titetil/smart-tank-pcb/AIO.PNG

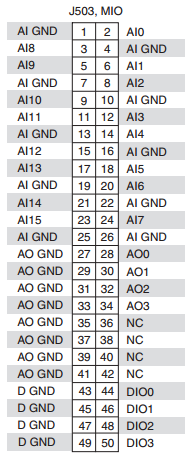
AIO.PNG
