titetil/smart-tank-pcb/RMC.PNG

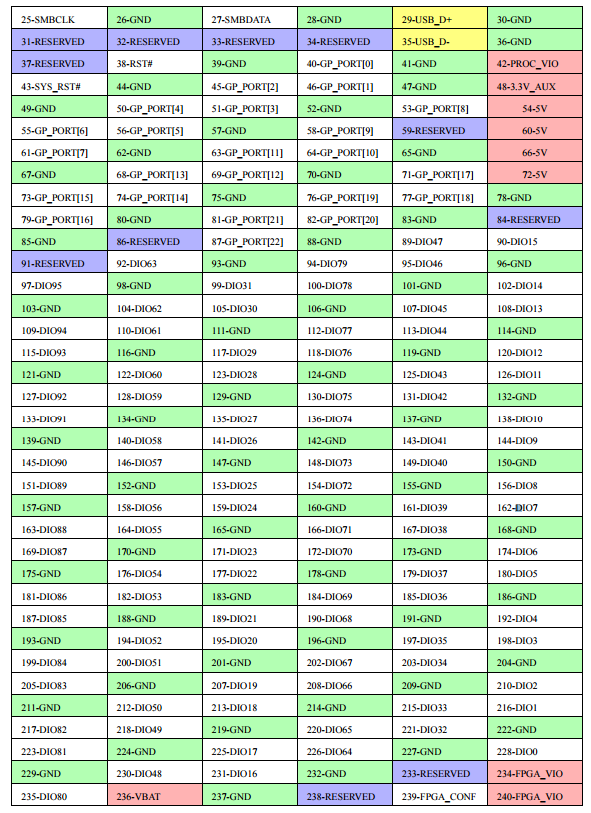
RMC.PNG
