titetil/smart-tank-pcb/Motherboard/Smart Tank PCB (Bill of Materials), v1.2.xlsx

# | Qty | Part Number | Description | Manufacturer | Distributor | Link | Price | Total | Refdef | PCB | TE Supplied
1 | 7 | 1755752 | TERMINAL BLOCK HEADER, MALE, 12A, 4 POS, 5.08mm | PHOENIX CONTACT | DIGIKEY | Link (http://www.digikey.com/product-detail/en/phoenix-contact/1755752/277-1152-ND/260520) | $1.66 | $11.62 | PWR_CONN1, PUMP_V_CONN_1-6 | X
2 | 7 | 1792265 | TERMINAL BLOCK PLUG, FEMALE, 12A, 4 POS, 5.08mm, SCREW | PHOENIX CONTACT | DIGIKEY | Link (http://www.digikey.com/product-detail/en/phoenix-contact/1792265/277-1042-ND/260410) | $5.01 | $35.07 | -
3 | 1 | 1755778 | TERMINAL BLOCK HEADER, MALE, 12A, 6 POS, 5.08mm | PHOENIX CONTACT | DIGIKEY | Link (http://www.digikey.com/product-search/en?keywords=1755778) | $1.63 | $1.63 | AO_CONN1 | X
4 | 1 | 1792281 | TERMINAL BLOCK PLUG, FEMALE, 12A, 6 POS, 5.08mm, SCREW | PHOENIX CONTACT | DIGIKEY | Link (http://www.digikey.com/product-detail/en/phoenix-contact/1792281/277-1044-ND/260412) | $5.81 | $5.81 | -
5 | 5 | 1755817 | TERMINAL BLOCK HEADER, MALE, 12A, 10 POS, 5.08mm | PHOENIX CONTACT | DIGIKEY | Link (http://www.digikey.com/product-detail/en/phoenix-contact/1755817/277-1158-ND/260526) | $3.66 | $18.30 | GPIO_CONN1, PRESSURE_CONN1, FLOW_CONN1, PH_VOLT_CONN1, SP1-6_CONN1 | X
6 | 5 | 1792320 | TERMINAL BLOCK PLUG, FEMALE, 12A, 10 POS, 5.08mm, SCREW | PHOENIX CONTACT | DIGIKEY | Link (http://www.digikey.com/product-detail/en/phoenix-contact/1792320/277-1048-ND/260416) | $11.27 | $56.35 | -
7 | 12 | 1906129 | TERMINAL BLOCK, 30A, 4 POS, 9.53mm, SCREW | PHOENIX CONTACT | DIGIKEY | Link (https://www.digikey.com/en/products/detail/phoenix-contact/1906129/3597016) | $4.30 | $51.60 | PUMP_PWR_CONN_1-6, PUMP_CONN_1-6 | X
8 | 1 | 1729128 | TERMINAL BLOCK, 10A, 2 POS, 5.08mm, SCREW | PHOENIX CONTACT | DIGIKEY | Link (http://www.digikey.com/product-detail/en/phoenix-contact/1729128/277-1247-ND/260615) | $1.33 | $1.33 | RIO_PWR_CONN_1 | X
9
10 | 6 | CBD13W6F35S600X/AA | D-SUB CONNECTOR, PCB, FEMALE, 6 POWER, 7 SIGNAL | POSITRONIC | POSITRONIC | Link (https://www.posishop.com/store/default.aspx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) | $25.93 | $155.58 | CTRL_CONN_1-6 | X | X
11 | 6 | D00000T0/AA | JACKSCREWS, FEMALE, PAIR | POSITRONIC | POSITRONIC | Link (https://www.posishop.com/store/default.aspx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) | $1.80 | $10.80 | - |  | X
12 | 6 | CBD13W6M2000Z/AA | D-SUB CONNECTOR, MATING, MALE, 6 POWER, 7 SIGNAL | POSITRONIC | POSITRONIC | Link (https://www.posishop.com/store/default.aspx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) | $5.02 | $30.12 | - |  | X
13 | 36 | MS4012D/AA | REMOVABLE CONTACT, SOLDER CUP, SIZE 8, MALE | POSITRONIC | POSITRONIC | Link (https://www.posishop.com/store/default.aspx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) | $0.78 | $28.08 | - |  | X
14 | 6 | D37000Z00/AA | D-SUB HOOD, MALE JACKSCREWS | POSITRONIC | POSITRONIC | Link (https://www.posishop.com/store/default.aspx?appname=Store&tabname=Product+Selection&PartNumber=D37000Z00/AA) | $6.16 | $36.96 | - |  | X
15
16 | 1 | SEAM-40-03.0-S-06-2-A-K-TR | .050" SEARAY™, 240 Pins | SAMTEC | SAMTEC | Link (https://www.digikey.com/en/products/detail/samtec-inc/SEAM-40-03-0-S-06-2-A-K-TR/6561658) | $22.38 | $22.38 | RMC_CONN1 | X
17
18 | 1 | SBH11-PBPC-D25-ST-BK | CONN HEADER, 0.1", 50 POS, GOLD | SULLINS | DIGIKEY | Link (http://www.digikey.com/product-detail/en/sullins-connector-solutions/SBH11-PBPC-D25-ST-BK/S9176-ND/1990069) | $0.92 | $0.92 | EXPANSION_CONN1 | X
19 | 1 | SBH21-NBPN-D25-ST-BK | CONN HEADER, 2mm, 50 POS, GOLD | SULLINS | DIGIKEY | Link (http://www.digikey.com/product-detail/en/sullins-connector-solutions/SBH21-NBPN-D25-ST-BK/S9026-ND/1989759) | $1.27 | $1.27 | RIO_AIO_CONN1 | X
20 | 4 | SBH11-PBPC-D05-ST-BK | CONN HEADER, 0.1", 10 POS, GOLD | SULLINS | DIGIKEY | Link (https://www.digikey.com/en/products/detail/sullins-connector-solutions/SBH11-PBPC-D05-ST-BK/1990062) | $0.29 | $1.16 | HMI_CONN1, RS232_CONN1, RS485_CONN1, CAN_CONN1 | X
21 | 1 | HCSD-05-D-02.00-01-N-G | 10 POS, 0.1", IDC CONNECTOR ASSEMBLY, 2" | SAMTEC | SAMTEC | Link (https://www.samtec.com/products/hcsd-05-d-02.00-01-n-g) | $6.59 | $6.59 | - |  | X
22 | 1 | HCSD-05-D-04.00-01-N-G-R | 10 POS, 0.1", IDC CONNECTOR ASSEMBLY, REVERSE, 4" | SAMTEC | SAMTEC | Link (https://www.samtec.com/products/hcsd-05-d-04.00-01-n-g-r) | $6.66 | $6.66 | - |  | X
23 | 1 | TCSD-25-D-01.25-01-N | 50 POS, 2mm, IDC CONNECTOR ASSEMBLY, 1.25" | SAMTEC | SAMTEC | Link (https://www.samtec.com/products/tcsd) | $14.28 | $14.28 | - |  | X
24
25 | 11 | 63969-1 | CONN QC RCPT 0.205/0.250 SOLDER | TE CONNECTIVITY | DIGIKEY | Link (https://www.digikey.com/en/products/detail/te-connectivity-amp-connectors/63969-1/1131770) | $0.26 | $2.86 | CAL2-12 | X
26 | 1 | 961103-6404-AR | CONN HEADER, 3 POS, 0.1", STR, GOLD | 3M | DIGIKEY | Link (https://www.digikey.com/product-detail/en/3m/961103-6404-AR/3M9457-03-ND/7104634?WT.srch=1) | $0.57 | $0.57 | PWR_SEL1 | X
27 | 1 | SNT-100-BK-G | JUMPER, 2 POS, 0.1", GOLD | SAMTEC | DIGIKEY | Link (https://www.digikey.com/en/products/detail/samtec-inc/SNT-100-BK-G/1756763) | $0.31 | $0.31 | -
28 | 1 | SDA12H1SBD | SWITCH SLIDE DIP SPST 0.025A 24V, 12 POS | C&K | DIGIKEY | Link (https://www.digikey.com/en/products/detail/c-k/SDA12H1SBD/949963) | $3.70 | $3.70 | VOLT_SENSE1 | X
29 | 1 | B3FS-1002P | SWITCH TACTILE SPST-NO 0.05A 24V | OMRON | DIGIKEY | Link (https://www.digikey.com/en/products/detail/omron-electronics-inc-emc-div/B3FS-1002P/277813) | $0.45 | $0.45 | RST_SW1 | X
30
31 | 1 | G6L-1F-DC24 | RELAY, SPST, 24V COIL, 1A CONTACT | OMRON | DIGIKEY | Link (http://www.digikey.com/product-detail/en/omron-electronics-inc-emc-div/G6L-1F-DC24/Z2040-ND/503110) | $3.43 | $3.43 | E-STOP_RLY1 | X
32 | 6 | VCF4-1000 | RELAY SOCKET, 30A | TE | DIGIKEY | Link (http://www.digikey.com/product-detail/en/te-connectivity-potter-brumfield-relays/VCF4-1000/PB232-ND/207273) | $3.01 | $18.06 | PWR_RLY_1-6 | X
33 | 6 | A21CSQ24VDC1.6 | RELAY AUTOMOTIVE SPDT 40A 24V | CIT | DIGIKEY | Link (https://www.digikey.com/en/products/detail/cit-relay-and-switch/A21CSQ24VDC1-6/12418796) | $2.50 | $15.00 | -
34
35 | 6 | INA240A2EDRQ1 | IC CURRENT SENSE 1 CIRCUIT 8SOIC | TI | DIGIKEY | Link (https://www.digikey.com/en/products/detail/texas-instruments/INA240A2EDRQ1/9861455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) | $4.03 | $24.18 | PUMP_AMPS_1-6 | X
36 | 6 | INA240A3EDRQ1 | IC CURRENT SENSE 1 CIRCUIT 8SOIC | TI | DIGIKEY | Link (https://www.digikey.com/en/products/detail/texas-instruments/INA240A3EDRQ1/9861456) | $4.03 | $24.18 | CTRL_AMPS_1-6 | X
37 | 12 | WSL40261L000FEA | RES 0.001 OHM 1% 3W 4026 | VISHAY DALE | DIGIKEY | Link (https://www.digikey.com/en/products/detail/texas-instruments/INA240A3EDRQ1/9861456) | $2.62 | $31.44 | PUMP_SHUNT_1-6, CTRL_SHUNT_1-6 | X
38 | 4 | ADS8332IBPWR | IC ADC 16BIT SAR 24TSSOP | TI | DIGIKEY | Link (https://www.digikey.com/en/products/detail/texas-instruments/ADS8332IBPWR/2695887) | $14.40 | $57.60 | ADC_AI16-23, ADC_AI24-31, ADC_AI32-39, ADC_AI40-47 | X
39 | 2 | LM358DT | IC OPAMP GP 1.1MHZ 8SO | ST MICROELECTRONICS | DIGIKEY | Link (http://www.digikey.com/product-detail/en/stmicroelectronics/LM358DT/497-1591-1-ND/592083) | $0.18 | $0.36 | U1, U2 | X
40
41 | 14 | 01220083Z | FUSE CLIP CARTRIDGE 250V 30A PCB | LITTELFUSE | DIGIKEY | Link (http://www.digikey.com/product-detail/en/littelfuse-inc/01220083Z/F3782-ND/2498890) | $0.86 | $12.04 | 24VDC_FUSE1, PUMP_FUSE_1-6 | X
42 | 1 | 0312003.MXP | FUSE GLASS 3A 250VAC 3AB 3AG | LITTELFUSE | DIGIKEY | Link (http://www.digikey.com/product-search/en?keywords=0312003.MXP) | $0.52 | $0.52 | -
43 | 6 | 0326025.MXP | FUSE CERM 25A 250VAC 125VDC 3AB | LITTELFUSE | DIGIKEY | Link (http://www.digikey.com/product-detail/en/littelfuse-inc/0326025.MXP/F1778-ND/778638) | $2.23 | $13.38 | -
44
45 | 6 | ZVN3320FTA | MOSFET N-CH 200V 0.60A SOT-23-3 | DIODES INCORPORATED | DIGIKEY | Link (https://www.digikey.com/en/products/detail/diodes-incorporated/ZVN3320FTA/152481) | $0.42 | $2.52 | Q3, Q8, Q12, Q16, Q20, Q24 | X
46 | 7 | DMN61D8LQ-13 | MOSFET N-CH 60V 470MA SOT23 | DIODES INCORPORATED | DIGIKEY | Link (https://www.digikey.com/en/products/detail/diodes-incorporated/DMN61D8LQ-13/5488598) | $0.74 | $5.18 | Q1, Q2, Q10, Q14, Q18, Q22, Q26 | X
47
48 | 6 | S1J | DIODE STANDARD 600V 1A DO214AC | DIOTEC | DIGIKEY | Link (https://www.digikey.com/en/products/detail/diotec-semiconductor/S1J/13163889) | $0.14 | $0.84 | D1, D3, D4, D5, D7, D9 | X
49 | 6 | 1N4148W-TP | DIODE GEN PURP 100V 150MA SOD123 | MICRO COMMERCIAL | DIGIKEY | Link (http://www.digikey.com/product-detail/en/micro-commercial-co/1N4148W-TP/1N4148WTPMSCT-ND/717311) | $0.12 | $0.75 | D6, D8, D10, D12, D14-15 | X
50 | 1 | RC1206JR-07120RL | RES SMD 120 OHM 5% 1/4W 1206 | YAGEO | DIGIKEY | Link (http://www.digikey.com/product-detail/en/yageo/RC1206JR-07120RL/311-120ERCT-ND/732162) | $0.02 | $0.02 | R19 | X
51 | 6 | RC1206JR-13150RL | RES 150 OHM 5% 1/4W 1206 | YAGEO | DIGIKEY | Link (https://www.digikey.com/en/products/detail/yageo/RC1206JR-13150RL/14286768) | $0.10 | $0.60 | R5, R52, R61, R70, R79, R88 | X
52 | 12 | RG3216P-2490-B-T1 | RES SMD 249 OHM 0.1% 1/4W 1206 | SUSUMU | DIGIKEY | Link (http://www.digikey.com/product-detail/en/susumu/RG3216P-2490-B-T1/RG32P249BCT-ND/2078665) | $0.24 | $2.88 | R20-31 | X
53 | 6 | RC1206JR-132KL | RES 2K OHM 5% 1/4W 1206 | YAGEO | DIGIKEY | Link (https://www.digikey.com/en/products/detail/yageo/RC1206JR-132KL/17016463) | $0.10 | $0.60 | R1, R8-12 | X
54 | 6 | RC1206JR-0710KL | RES 10K OHM 5% 1/4W 1206 | YAGEO | DIGIKEY | Link (https://www.digikey.com/en/products/detail/yageo/RC1206JR-1310KL/14286743) | $0.10 | $0.60 | R6, R49, R58, R67, R76, R85 | X
55 | 12 | RNCS1206BKE10K0 | RES SMD 10K OHM 0.1% 1/8W 1206 | STACKPOLE ELECTRONICS | DIGIKEY | Link (https://www.digikey.com/product-detail/en/stackpole-electronics-inc/RNCS1206BKE10K0/RNCS1206BKE10K0CT-ND/1800331) | $0.17 | $2.04 | R2, R14, R16, R33, R35, R37, R47, R56, R65, R74, R83, R92 | X
56 | 2 | RNCF1206BKC15K0 | RES SMD 15K OHM 0.1% 1/4W 1206 | STACKPOLE ELECTRONICS | DIGIKEY | Link (https://www.digikey.com/product-detail/en/stackpole-electronics-inc/RNCF1206BKC15K0/RNCF1206BKC15K0CT-ND/2027173) | $0.15 | $0.30 | R17, R18 | X
57 | 12 | RNCS1206BKE100K | RES SMD 100K OHM 0.1% 1/8W 1206 | STACKPOLE ELECTRONICS | DIGIKEY | Link (https://www.digikey.com/product-detail/en/stackpole-electronics-inc/RNCS1206BKE100K/RNCS1206BKE100KCT-ND/1800328) | $0.17 | $2.04 | R3, R4, R15, R32, R34, R36, R48, R57, R66, R75, R84, R93 | X
58 | 6 | RC1206JR-071ML | RES SMD 1M OHM 5% 1/4W 1206 | YAGEO | DIGIKEY | Link (http://www.digikey.com/product-detail/en/yageo/RC1206JR-071ML/311-1.0MERCT-ND/732134) | $0.10 | $0.60 | R7, R55, R64, R73, R82, R91 | X
59 | 12 | CC1206KRX7R9BB472 | 4700pF 50V CERAMIC CAPACITOR X7R 1206 | YAGEO | DIGIKEY | Link (http://www.digikey.com/product-detail/en/yageo/CC1206KRX7R9BB472/311-1173-1-ND/303083) | $0.19 | $2.28 | C20, C21, C29, C30, C33, C34, C37, C38, C41, C42, C45, C46 | X
60 | 6 | CC1206KRX7R9BB103 | CAP CER 10000PF 50V X7R 1206 | YAGEO | DIGIKEY | Link (https://www.digikey.com/en/products/detail/yageo/CC1206KRX7R9BB103/302908) | $0.19 | $1.14 | C14, C17, C23, C24, C25, C26 | X
61 | 12 | CC1206KRX7R9BB104 | 0.1µF 50V CERAMIC CAPACITOR X7R 1206 | YAGEO | DIGIKEY | Link (http://www.digikey.com/product-detail/en/yageo/CC1206KRX7R9BB104/311-1179-1-ND/303089) | $0.15 | $1.80 | C13, C15, C27, C28, C31, C32, C35, C36, C39, C40, C43, C44 | X
62 | 8 | CC1206ZRY5V7BB475 | 4.7µF 16V CERAMIC CAPACITOR Y5V (F) 1206 | YAGEO | DIGIKEY | Link (http://www.digikey.com/product-detail/en/yageo/CC1206ZRY5V7BB475/311-2011-1-ND/5195913) | $0.21 | $1.68 | C1, C3, C4, C6, C7, C9, C10, C12 | X
63 | 4 | CC1206KKX5R5BB226 | 22µF 6.3V CERAMIC CAPACITOR X5R 1206 | YAGEO | DIGIKEY | Link (http://www.digikey.com/product-detail/en/yageo/CC1206KKX5R5BB226/311-1937-1-ND/5195839) | $0.30 | $1.20 | C2, C5, C8, C11 | X
64 | 1 | EEE-HD1C100AR | CAP ALUM 10UF 20% 16V SMD | PANASONIC | DIGIKEY | Link (https://www.digikey.com/en/products/detail/panasonic-electronic-components/EEE-HD1C100AR/1985127) | $0.42 | $0.42 | C16 | X
65
66 | 19 | SMTSO-116-12ET | SURFACE MOUNT STANDOFF, 3/8", THRU HOLE, FOR 4-40 | PENN ENGINEERING | PENN ENGINEERING | Link (http://catalog.pemnet.com/item/uts-and-spacers-standoffs-surface-mount-type-smtso/spacers-standoffs---type-smtsob---unified/smtsob-116-12et) |  |  | S1-15, S24-27 | X
67 | 10 | SMTSO-440-12ET | SURFACE MOUNT STANDOFF, 3/8", 4-40 | PENN ENGINEERING | PENN ENGINEERING | Link (http://catalog.pemnet.com/item/uts-and-spacers-standoffs-surface-mount-type-smtso/spacers-standoffs---type-smtsob---unified/smtsob-440-12et) |  |  | S16-23, S28, S29 | X | X
68
69 | 1 | 91737A069 | FILLISTER SCREW, 4-40, 3/16", PACK OF 100 | McMASTER-CARR | McMASTER-CARR | Link (http://www.mcmaster.com/#91737a069/=143emwn) | $4.22 | $4.22 | SBRIO STAND-OFF |  | X
70 | 1 | 91772A113 | PAN HEAD SCREW, 4-40, 3/4", PACK OF 100 | McMASTER-CARR | McMASTER-CARR | Link (https://www.mcmaster.com/#91772a113/=19kgcxo) | $4.95 | $4.95 | PCB STAND-OFF |  | X
71
72 | 1 | CUSTOM | PCB BACKPLATE, 1/2", DELRIN, BLACK | R&S TOOL | R&S TOOL |  | $94.75 | $94.75 | Smart Tank PCB Backplate.dwg |  | X
73 | 1 | 91255A622 | ROUNDED HEAD SCREW, 3/8"-16, 3/4", PACK OF 25 | McMASTER-CARR | McMASTER-CARR | Link (http://www.mcmaster.com/#91772a110/=143enhs) | $7.54 | $7.54 | Screws for backplate |  | X
74
75
