titetil/smart-tank-pcb/Motherboard/Smart_Tank_3D/WSL4026 (0.001).stp

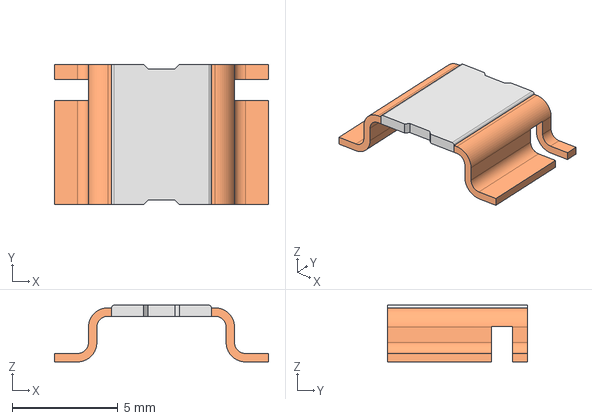
[picture p3: CAD file, 2025-11-17]
Motherboard/Smart_Tank_3D/WSL4026 (0.001).stp
10.1 x 6.60 x 2.68 mm
