titetil/smart-tank-pcb/Motherboard/Smart_Tank_3D/FEMALE_SPADE_QC_(TE_63969-1).step

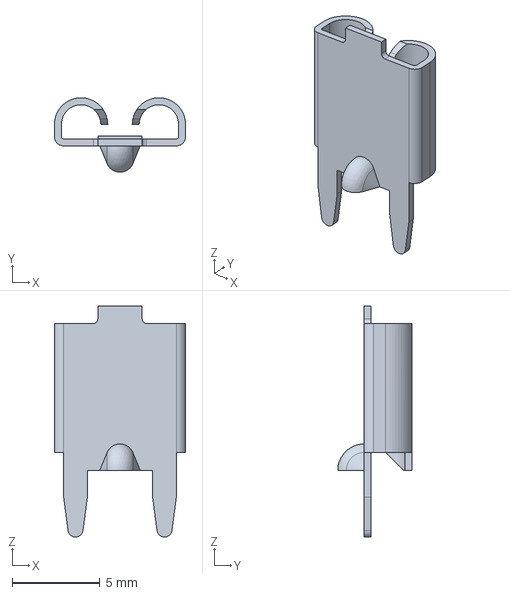
[picture p4: CAD file, 2025-11-17]
Motherboard/Smart_Tank_3D/FEMALE_SPADE_QC_(TE_63969-1).step
7.49 x 4.25 x 13.2 mm
