titetil/smart-tank-pcb/Smart Tank Controller Plate (Hella BLDC).dxf

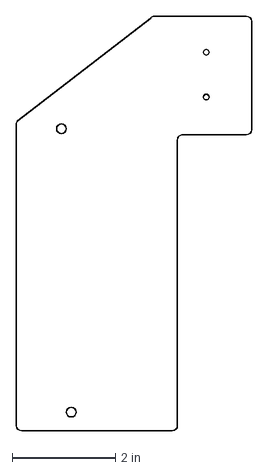
[picture p5: CAD file, 2017-07-27]
Smart Tank Controller Plate (Hella BLDC).dxf
4.56 x 8.05 in
