titetil/smart-tank-pcb/Motherboard/Smart_Tank_3D/EEEHD1C100AR.step

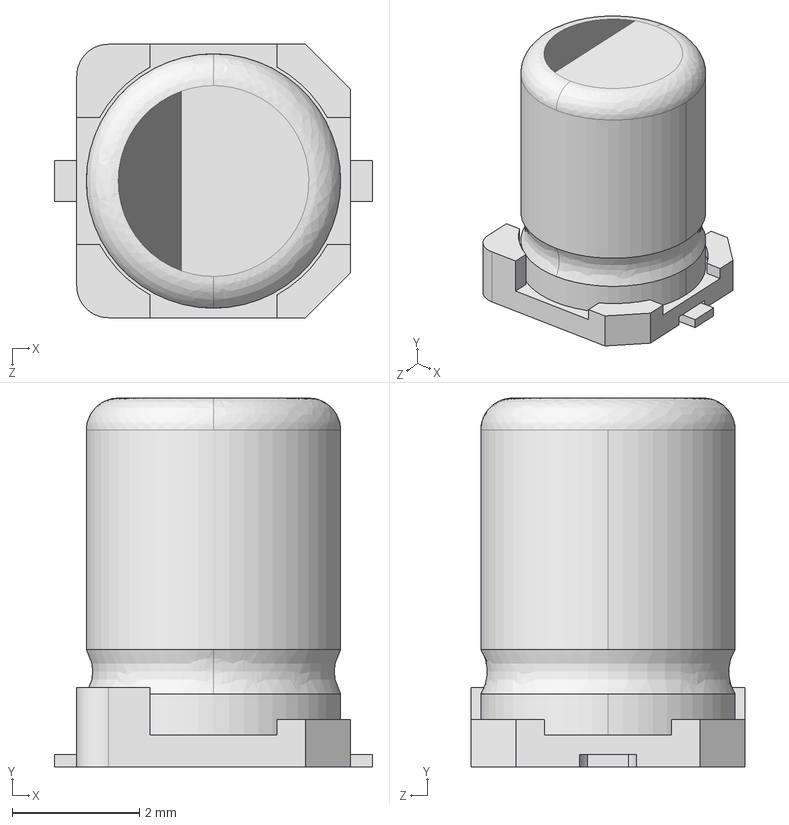
[picture p6: CAD file, 2025-11-17]
Motherboard/Smart_Tank_3D/EEEHD1C100AR.step
5.00 x 5.80 x 4.30 mm
