titetil/smart-tank-pcb/Smart Tank PCB Backplate.dxf

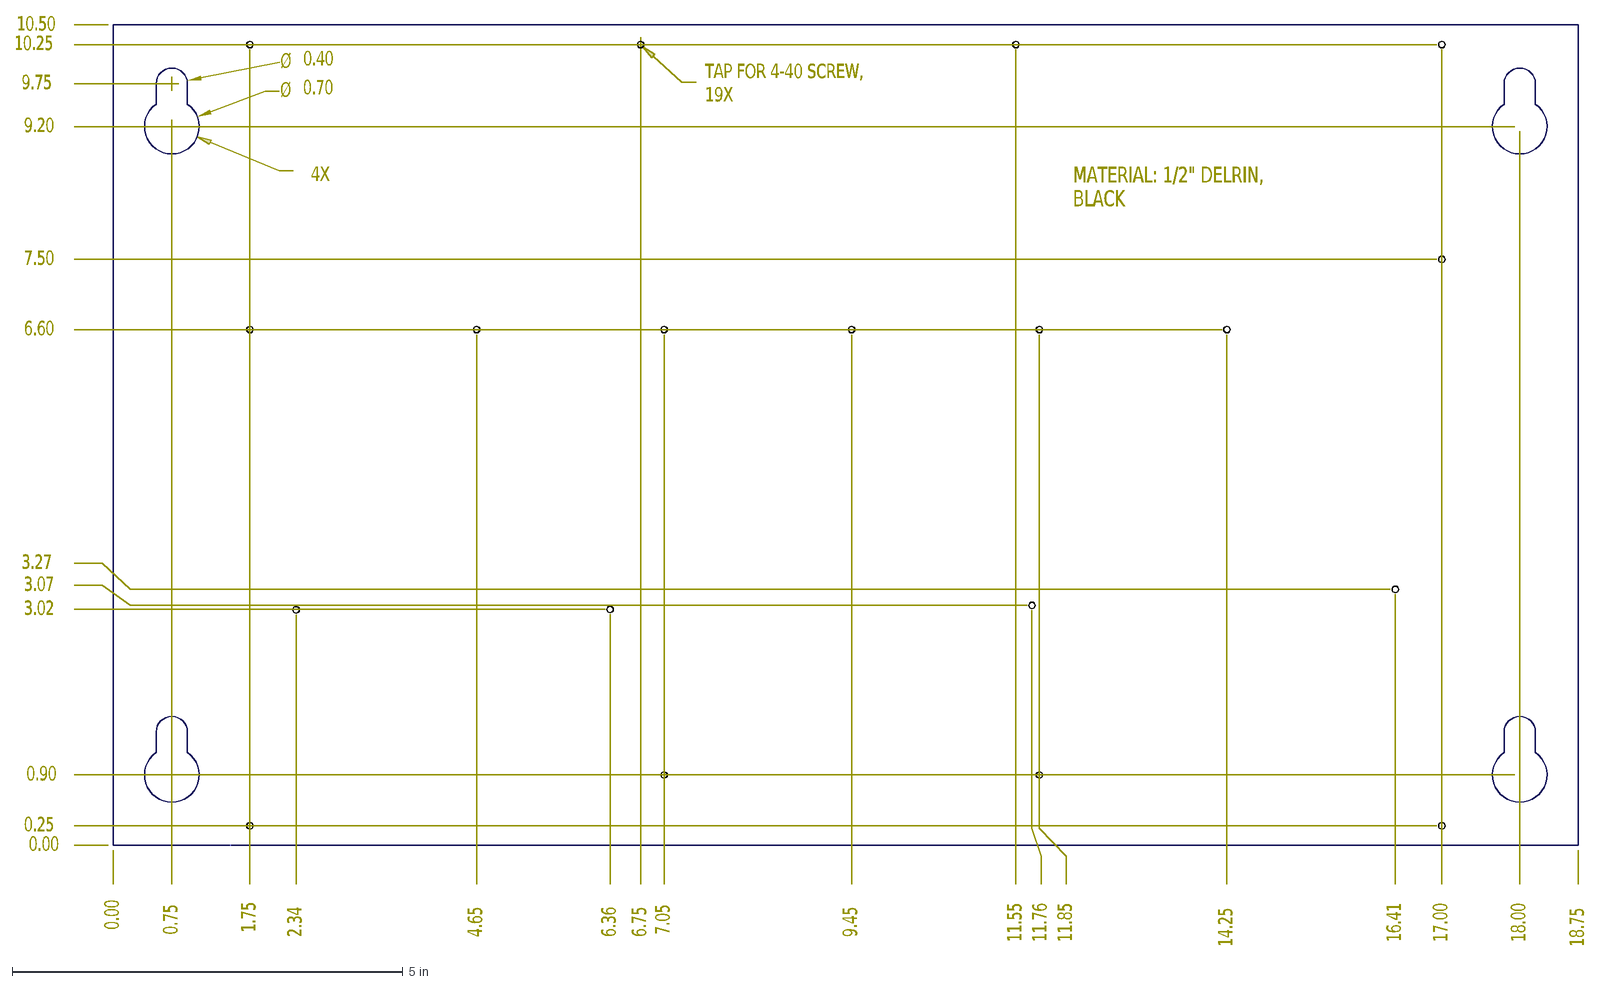
[picture p7: CAD file, 2017-03-30]
Smart Tank PCB Backplate.dxf
0.00
1.75
2.34
4.65
6.36
6.75
7.05
9.45
11.55
11.76
11.85
14.25
16.41
17.00
0.25
0.90
3.02
3.07
3.27
6.60
7.50
9.20
10.25
10.50
0.75
18.00
18.75
Ø
0.40
9.75
0.70
4X
TAP FOR 4-40 SCREW,
19X
MATERIAL: 1/2" DELRIN,
BLACK
