titetil/smart-tank-pcb/Motherboard/Smart_Tank_3D/SW_DIP_SPSTx12_(SDA12H1SBD).stp

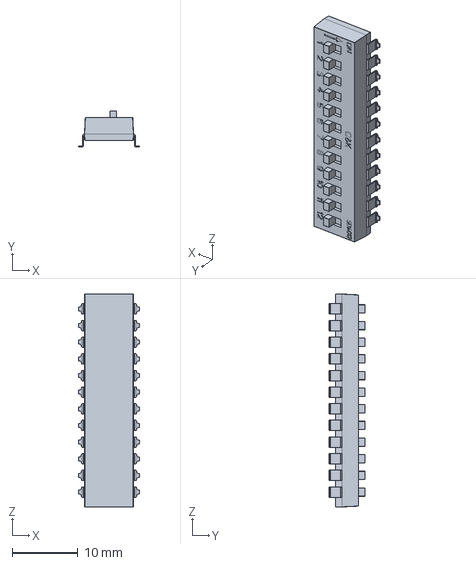
[picture p8: CAD file, 2025-11-14]
Motherboard/Smart_Tank_3D/SW_DIP_SPSTx12_(SDA12H1SBD).stp
9.30 x 5.50 x 32.5 mm
