titetil/smart-tank-pcb/(list of files, cad)

Other CAD files:
Smart Tank Controller Plate (Kuhnke).dwg
Smart Tank Controller Plate (Hella BLDC).dwg
Smart Tank PCB Backplate.dwg
