titetil/smart-tank-pcb/Smart Tank Controller Plate (Hella BLDC).pdf

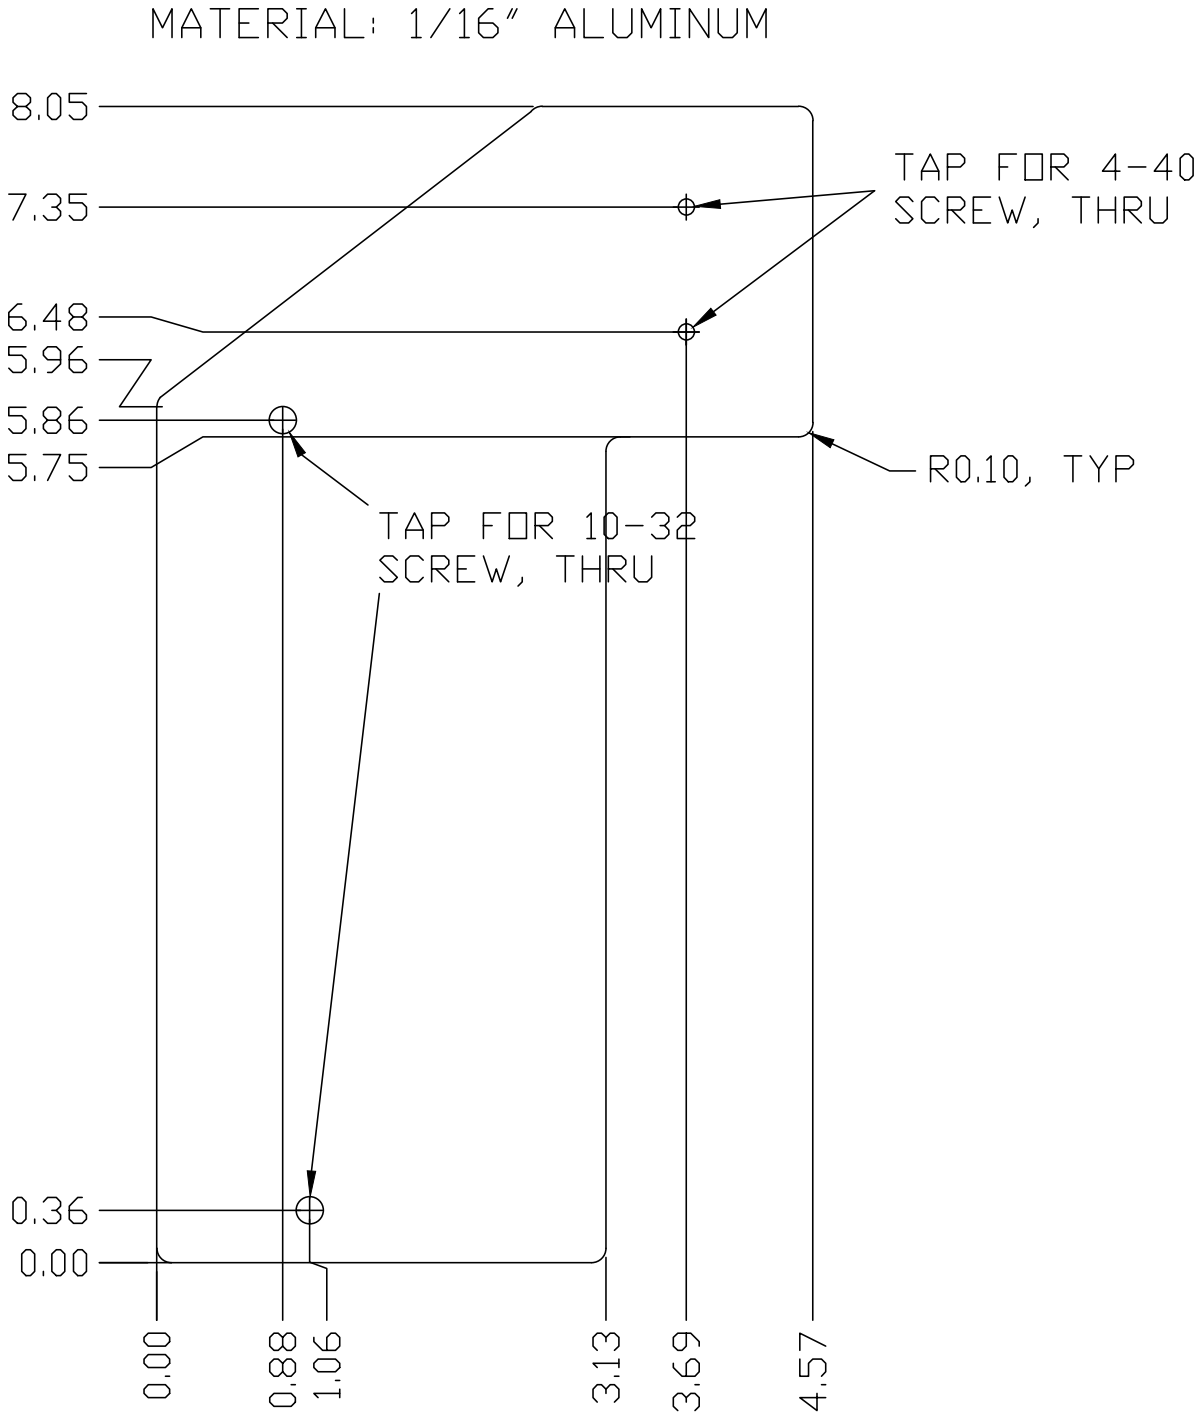
[picture p9: page 1]
