titetil/smart-tank-pcb/Smart Tank Controller Plate (Kuhnke).pdf

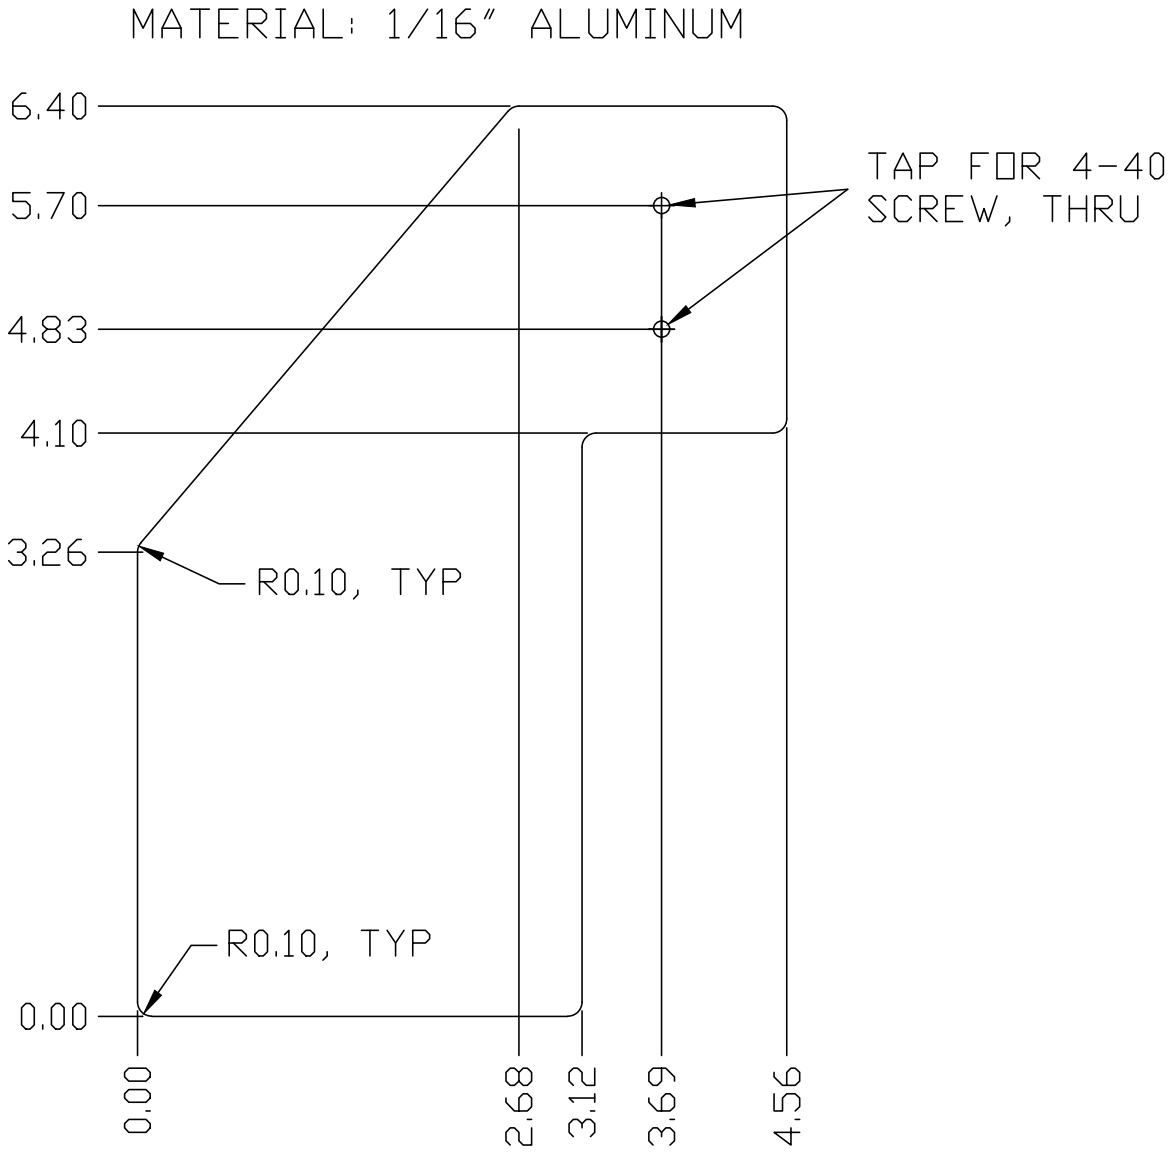
[picture p10: page 1]
