titetil/smart-tank-pcb/Smart Tank PCB Backplate.pdf

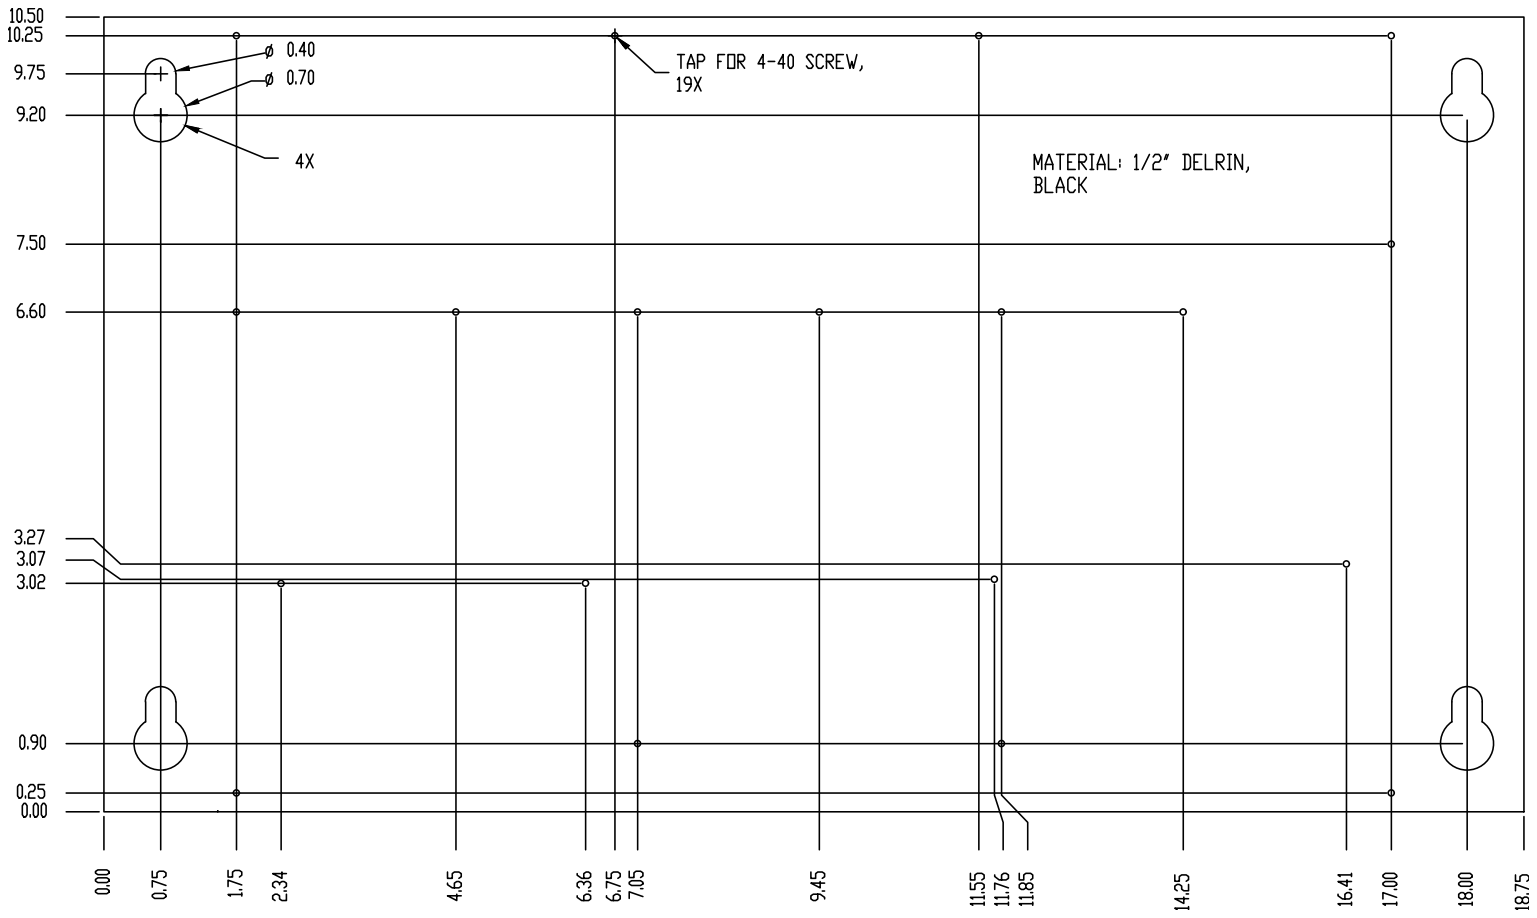
[picture p11: page 1]
