titetil/smart-tank-pcb/(list of files, drawings)

Other design files:
PWM Simulation.ms12
