titetil/smart-tank-pcb/Motherboard/Smart Tank Motherboard.kicad_pcb

## KiCad design Motherboard/Smart Tank Motherboard.kicad_pcb (2026-02-18)

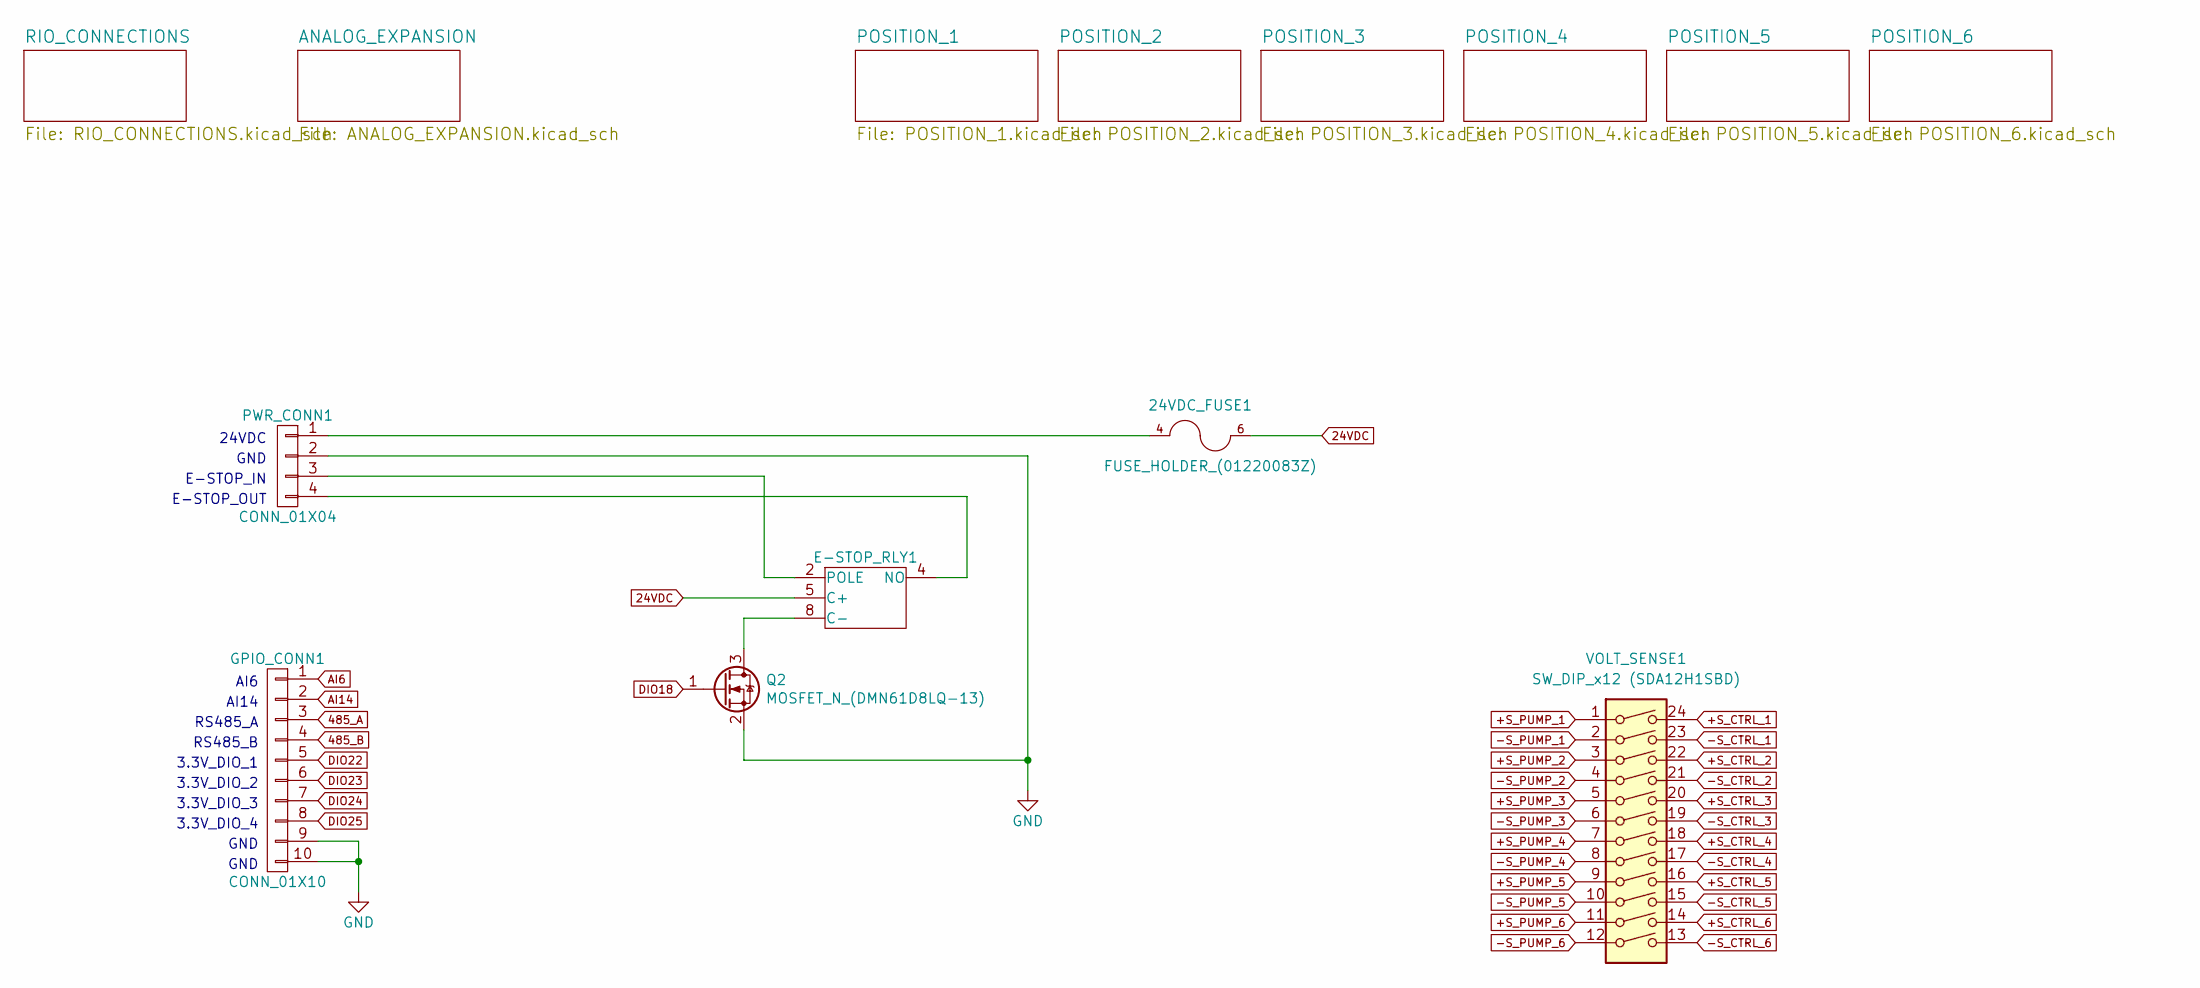
[picture p12: schematic Smart Tank Motherboard.kicad_sch]

Parts:
24VDC_FUSE1: FUSE_HOLDER_(01220083Z)
E-STOP_RLY1: OMRON_RELAY_(G6L-1F-DC24); OMRON_RELAY_1A_(G6L-1F-DC24)
GPIO_CONN1: CONN_01X10; PHX_TB_HDR_10_POS_STR_(1755817)
PWR_CONN1: CONN_01X04; PHX_TB_HDR_4_POS_STR_(1755752)
Q2: MOSFET_N_(DMN61D8LQ-13); SOT-23
VOLT_SENSE1: SW_DIP_x12 (SDA12H1SBD); SW_DIP_SPSTx12_(SDA12H1SBD)

Connections:
24VDC: 24VDC_FUSE1.6, 24VDC_FUSE1.7, E-STOP_RLY1.5 (C+); also elsewhere on the board
485_A: GPIO_CONN1.3; also elsewhere on the board
485_B: GPIO_CONN1.4; also elsewhere on the board
+S_CTRL_1: VOLT_SENSE1.24; also elsewhere on the board
+S_CTRL_2: VOLT_SENSE1.22; also elsewhere on the board
+S_CTRL_3: VOLT_SENSE1.20; also elsewhere on the board
+S_CTRL_4: VOLT_SENSE1.18; also elsewhere on the board
+S_CTRL_5: VOLT_SENSE1.16; also elsewhere on the board
+S_CTRL_6: VOLT_SENSE1.14; also elsewhere on the board
+S_PUMP_1: VOLT_SENSE1.1; also elsewhere on the board
+S_PUMP_2: VOLT_SENSE1.3; also elsewhere on the board
+S_PUMP_3: VOLT_SENSE1.5; also elsewhere on the board
+S_PUMP_4: VOLT_SENSE1.7; also elsewhere on the board
+S_PUMP_5: VOLT_SENSE1.9; also elsewhere on the board
+S_PUMP_6: VOLT_SENSE1.11; also elsewhere on the board
-S_CTRL_1: VOLT_SENSE1.23; also elsewhere on the board
-S_CTRL_2: VOLT_SENSE1.21; also elsewhere on the board
-S_CTRL_3: VOLT_SENSE1.19; also elsewhere on the board
-S_CTRL_4: VOLT_SENSE1.17; also elsewhere on the board
-S_CTRL_5: VOLT_SENSE1.15; also elsewhere on the board
-S_CTRL_6: VOLT_SENSE1.13; also elsewhere on the board
-S_PUMP_1: VOLT_SENSE1.2; also elsewhere on the board
-S_PUMP_2: VOLT_SENSE1.4; also elsewhere on the board
-S_PUMP_3: VOLT_SENSE1.6; also elsewhere on the board
-S_PUMP_4: VOLT_SENSE1.8; also elsewhere on the board
-S_PUMP_5: VOLT_SENSE1.10; also elsewhere on the board
-S_PUMP_6: VOLT_SENSE1.12; also elsewhere on the board
AI6: GPIO_CONN1.1; also elsewhere on the board
AI14: GPIO_CONN1.2; also elsewhere on the board
DIO18: Q2.1 (G); also elsewhere on the board
DIO22: GPIO_CONN1.5; also elsewhere on the board
DIO23: GPIO_CONN1.6; also elsewhere on the board
DIO24: GPIO_CONN1.7; also elsewhere on the board
DIO25: GPIO_CONN1.8; also elsewhere on the board
GND: GPIO_CONN1.9, GPIO_CONN1.10, PWR_CONN1.2, Q2.2 (S); also elsewhere on the board
unnamed: E-STOP_RLY1.8 (C-), Q2.3 (D)
unnamed: E-STOP_RLY1.4 (NO), PWR_CONN1.4
unnamed: E-STOP_RLY1.2 (POLE), PWR_CONN1.3
unnamed: 24VDC_FUSE1.4, 24VDC_FUSE1.5, PWR_CONN1.1

Notes on the sheet:
RS485_B
3.3V_DIO_3
RS485_A
E-STOP_IN
24VDC
GND
3.3V_DIO_4
E-STOP_OUT
3.3V_DIO_2
AI6
AI14
3.3V_DIO_1

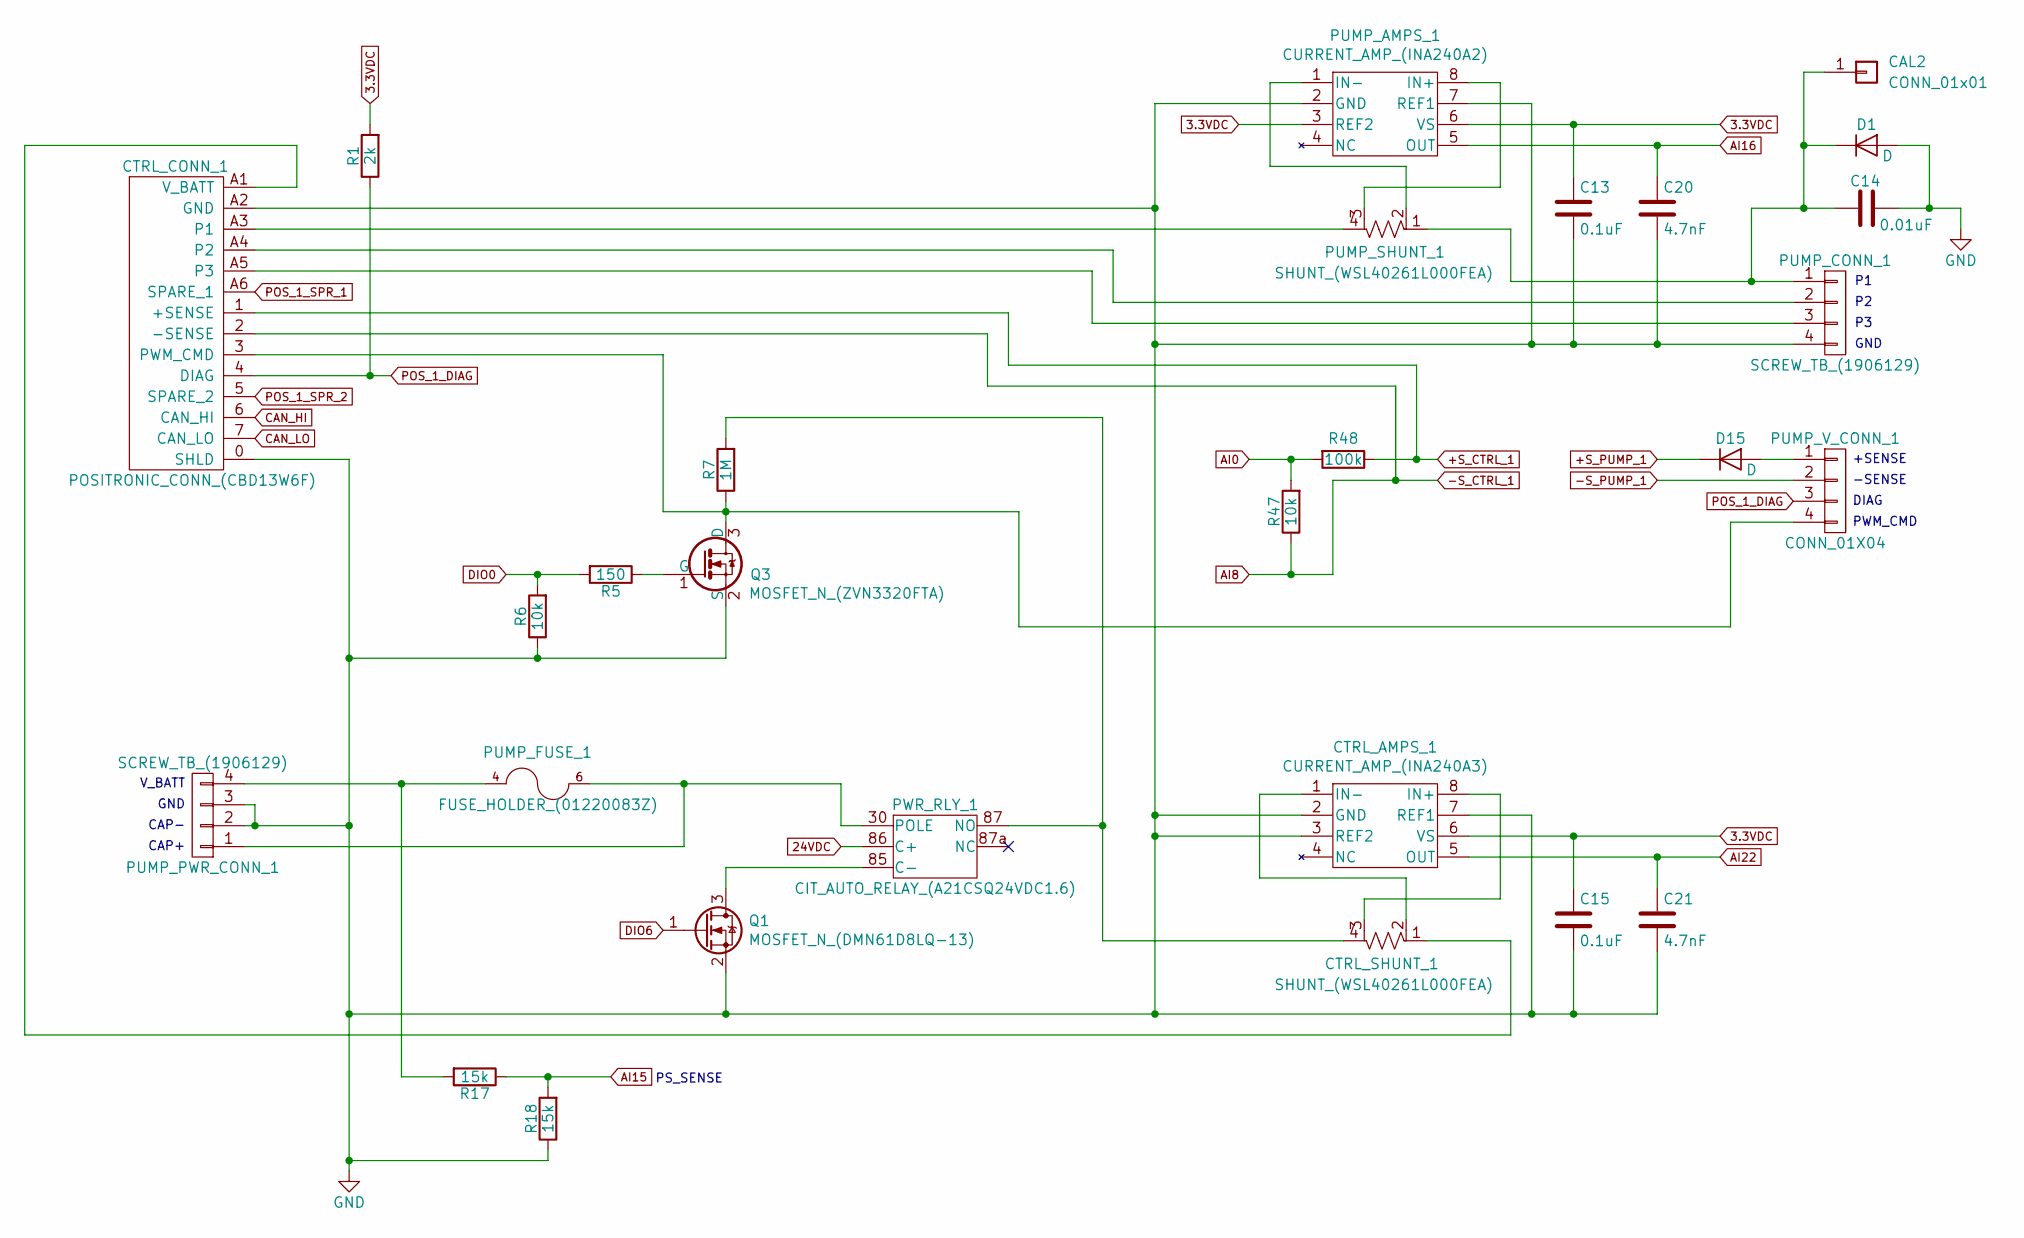
[picture p13: schematic POSITION_1.kicad_sch]

Parts:
C13, C15: 0.1uF; C_1206_3216Metric
C14: 0.01uF; C_1206_3216Metric
C20, C21: 4.7nF; C_1206_3216Metric
CAL2: CONN_01x01; FEMALE_SPADE_QC_(TE_63969-1)
CTRL_AMPS_1: CURRENT_AMP_(INA240A3); SOIC-8_3.9x4.9mm_P1.27mm
CTRL_CONN_1: POSITRONIC_CONN_(CBD13W6F); POSITRONIC_D-SUB_(CBD13W6F35S600X_AA)
CTRL_SHUNT_1: SHUNT_(WSL40261L000FEA)
D1, D15: D; D_SMA
PUMP_AMPS_1: CURRENT_AMP_(INA240A2); SOIC-8_3.9x4.9mm_P1.27mm
PUMP_CONN_1: SCREW_TB_(1906129); PHNX_TB_SCREW_4_POS_(1906129)
PUMP_FUSE_1: FUSE_HOLDER_(01220083Z)
PUMP_PWR_CONN_1: SCREW_TB_(1906129); PHNX_TB_SCREW_4_POS_(1906129)
PUMP_SHUNT_1: SHUNT_(WSL40261L000FEA)
PUMP_V_CONN_1: CONN_01X04; PHX_TB_HDR_4_POS_STR_(1755752)
PWR_RLY_1: CIT_AUTO_RELAY_(A21CSQ24VDC1.6); TE_AUTO_RELAY_SOCKET_(VCF4-1000)
Q1: MOSFET_N_(DMN61D8LQ-13); SOT-23
Q3: MOSFET_N_(ZVN3320FTA); SOT-23
R1: 2k; R_1206_3216Metric
R5: 150; R_1206_3216Metric
R6, R47: 10k; R_1206_3216Metric
R7: 1M; R_1206_3216Metric
R17, R18: 15k; R_1206_3216Metric
R48: 100k; R_1206_3216Metric

Connections:
3.3VDC: C13.1, C15.1, CTRL_AMPS_1.6 (VS), PUMP_AMPS_1.3 (REF2), PUMP_AMPS_1.6 (VS), R1.2; also elsewhere on the board
24VDC: PWR_RLY_1.86 (C+); also elsewhere on the board
+S_CTRL_1: CTRL_CONN_1.1 (+SENSE), R48.1; also elsewhere on the board
+S_PUMP_1: D15.1 (K); also elsewhere on the board
-S_CTRL_1: CTRL_CONN_1.2 (-SENSE), R47.1; also elsewhere on the board
-S_PUMP_1: PUMP_V_CONN_1.2; also elsewhere on the board
AI0: R47.2, R48.2; also elsewhere on the board
AI15: R17.1, R18.2; also elsewhere on the board
AI16: C20.1, PUMP_AMPS_1.5 (OUT); also elsewhere on the board
AI22: C21.1, CTRL_AMPS_1.5 (OUT); also elsewhere on the board
CAN_HI: CTRL_CONN_1.6 (CAN_HI); also elsewhere on the board
CAN_LO: CTRL_CONN_1.7 (CAN_LO); also elsewhere on the board
DIO0: R5.2, R6.2; also elsewhere on the board
DIO6: Q1.1 (G); also elsewhere on the board
GND: C13.2, C14.2, C15.2, C20.2, C21.2, CTRL_AMPS_1.2 (GND), CTRL_AMPS_1.3 (REF2), CTRL_AMPS_1.7 (REF1), CTRL_CONN_1.0 (SHLD), CTRL_CONN_1.A2 (GND), D1.2 (A), PUMP_AMPS_1.2 (GND), PUMP_AMPS_1.7 (REF1), PUMP_CONN_1.4, PUMP_PWR_CONN_1.2, PUMP_PWR_CONN_1.3, Q1.2 (S), Q3.2 (S), R6.1, R18.1; also elsewhere on the board
unnamed: C14.1, CAL2.1, D1.1 (K), PUMP_CONN_1.1, PUMP_SHUNT_1.1
unnamed: CTRL_AMPS_1.8 (IN+), CTRL_SHUNT_1.3
unnamed: CTRL_AMPS_1.1 (IN-), CTRL_SHUNT_1.2
unnamed: CTRL_CONN_1.A3 (P1), PUMP_SHUNT_1.4
unnamed: CTRL_CONN_1.A4 (P2), PUMP_CONN_1.2
unnamed: CTRL_CONN_1.A5 (P3), PUMP_CONN_1.3
unnamed: CTRL_CONN_1.3 (PWM_CMD), PUMP_V_CONN_1.4, Q3.3 (D), R7.1
unnamed: CTRL_CONN_1.A1 (V_BATT), CTRL_SHUNT_1.1
unnamed: D15.2 (A), PUMP_V_CONN_1.1
unnamed: PUMP_AMPS_1.8 (IN+), PUMP_SHUNT_1.3
unnamed: PUMP_AMPS_1.1 (IN-), PUMP_SHUNT_1.2
unnamed: PUMP_FUSE_1.6, PUMP_FUSE_1.7, PUMP_PWR_CONN_1.1, PWR_RLY_1.30 (POLE)
unnamed: PUMP_FUSE_1.4, PUMP_FUSE_1.5, PUMP_PWR_CONN_1.4, R17.2
unnamed: PWR_RLY_1.85 (C-), Q1.3 (D)
unnamed: CTRL_SHUNT_1.4, PWR_RLY_1.87 (NO), R7.2
unnamed: Q3.1 (G), R5.1
POS_1_DIAG: CTRL_CONN_1.4 (DIAG), PUMP_V_CONN_1.3, R1.1; also elsewhere on the board
POS_1_SPR_1: CTRL_CONN_1.A6 (SPARE_1); also elsewhere on the board
POS_1_SPR_2: CTRL_CONN_1.5 (SPARE_2); also elsewhere on the board

Notes on the sheet:
V_BATT
DIAG
GND
CAP-
GND
PS_SENSE
CAP+
-SENSE
+SENSE
PWM_CMD

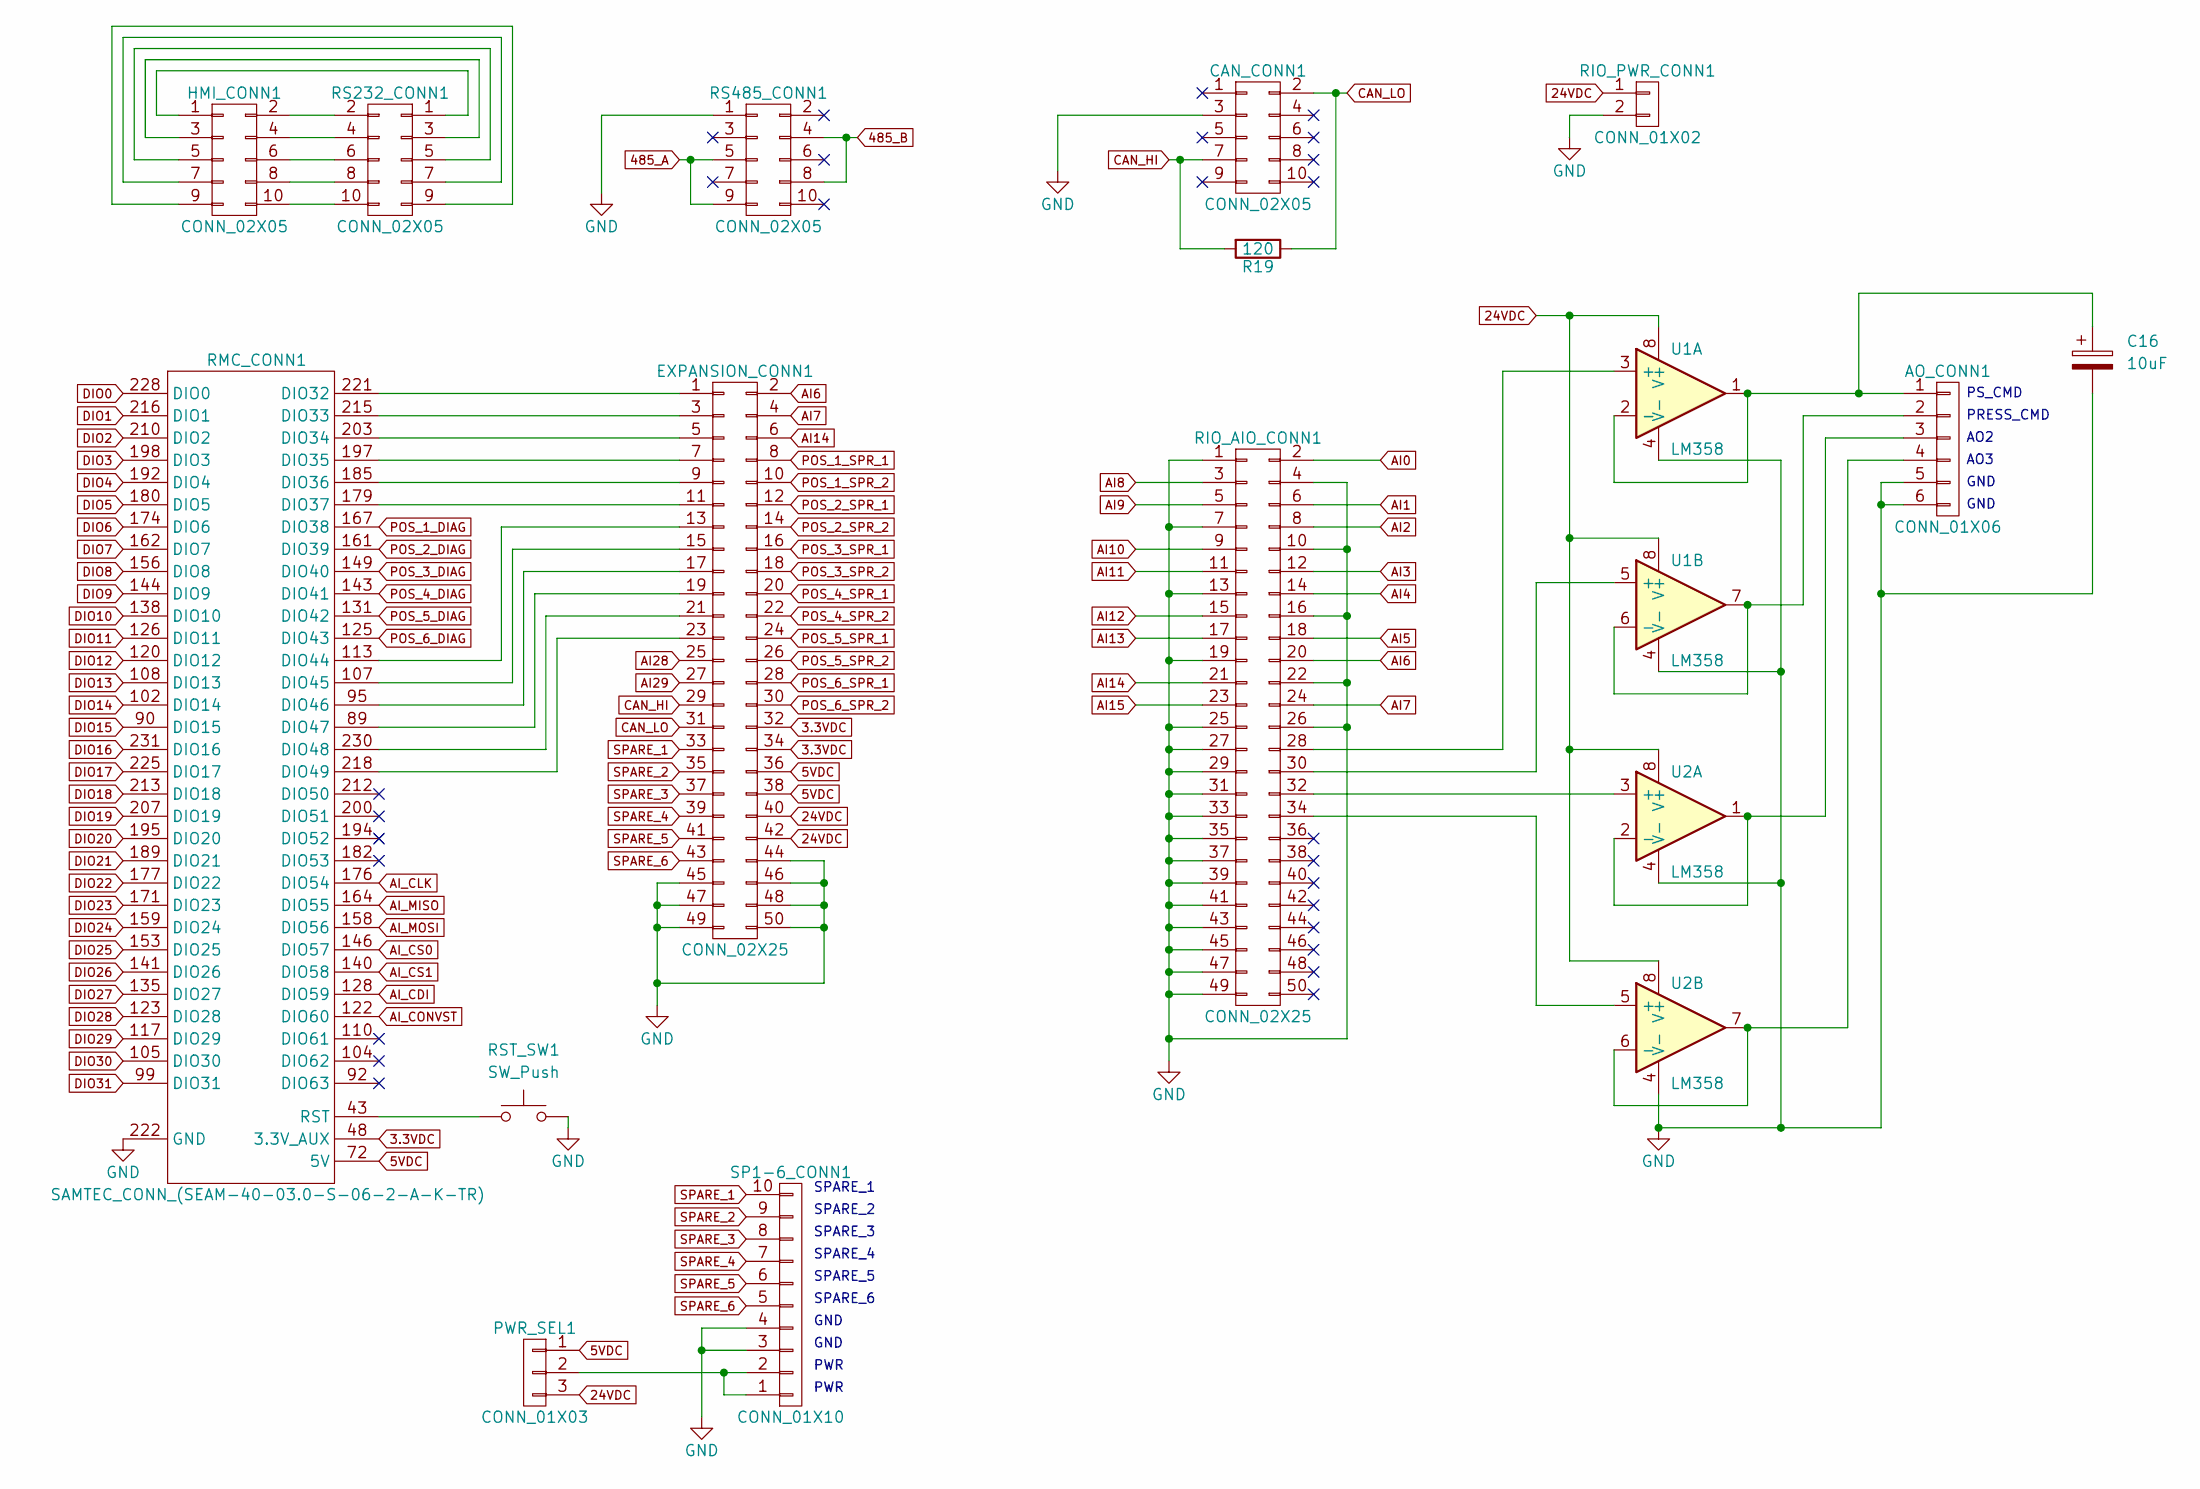
[picture p14: schematic RIO_CONNECTIONS.kicad_sch]

Parts:
AO_CONN1: CONN_01X06; PHX_TB_HDR_6_POS_STR_(1755778)
C16: 10uF; CAP_EEEHD1C100AR
CAN_CONN1: CONN_02X05; IDC_Header_Straight_10pins
EXPANSION_CONN1: CONN_02X25; IDC_Header_Straight_50pins
HMI_CONN1: CONN_02X05; IDC_Header_Straight_10pins
PWR_SEL1: CONN_01X03; PinHeader_1x03_P2.54mm_Vertical
R19: 120; R_1206_3216Metric
RIO_AIO_CONN1: CONN_02X25; 50-PIN_HEADER_2mm
RIO_PWR_CONN1: CONN_01X02; PHNX_TB_SCREW_2_POS_(1729128)
RMC_CONN1: SAMTEC_CONN_(SEAM-40-03.0-S-06-2-A-K-TR)
RS232_CONN1, RS485_CONN1: CONN_02X05; IDC_Header_Straight_10pins
RST_SW1: SW_Push; SW_SPST_Omron_B3FS-100xP
SP1-6_CONN1: CONN_01X10; PHX_TB_HDR_10_POS_STR_(1755817)
U1, U2: LM358; SOIC-8_3.9x4.9mm_Pitch1.27mm

Connections:
3.3VDC: EXPANSION_CONN1.32, EXPANSION_CONN1.34, RMC_CONN1.48 (3.3V_AUX); also elsewhere on the board
5VDC: EXPANSION_CONN1.36, EXPANSION_CONN1.38, PWR_SEL1.1, RMC_CONN1.54 (5V), RMC_CONN1.60 (5V), RMC_CONN1.66 (5V), RMC_CONN1.72 (5V); also elsewhere on the board
24VDC: EXPANSION_CONN1.40, EXPANSION_CONN1.42, PWR_SEL1.3, RIO_PWR_CONN1.1, U1.8 (V+), U2.8 (V+); also elsewhere on the board
485_A: RS485_CONN1.5, RS485_CONN1.9; also elsewhere on the board
485_B: RS485_CONN1.4, RS485_CONN1.8; also elsewhere on the board
-S_CTRL_1: RIO_AIO_CONN1.3; also elsewhere on the board
-S_CTRL_2: RIO_AIO_CONN1.5; also elsewhere on the board
-S_CTRL_3: RIO_AIO_CONN1.9; also elsewhere on the board
-S_CTRL_4: RIO_AIO_CONN1.11; also elsewhere on the board
-S_CTRL_5: RIO_AIO_CONN1.15; also elsewhere on the board
-S_CTRL_6: RIO_AIO_CONN1.17; also elsewhere on the board
AI0: RIO_AIO_CONN1.2; also elsewhere on the board
AI1: RIO_AIO_CONN1.6; also elsewhere on the board
AI2: RIO_AIO_CONN1.8; also elsewhere on the board
AI3: RIO_AIO_CONN1.12; also elsewhere on the board
AI4: RIO_AIO_CONN1.14; also elsewhere on the board
AI5: RIO_AIO_CONN1.18; also elsewhere on the board
AI6: EXPANSION_CONN1.2, RIO_AIO_CONN1.20; also elsewhere on the board
AI7: EXPANSION_CONN1.4, RIO_AIO_CONN1.24
AI14: EXPANSION_CONN1.6, RIO_AIO_CONN1.21; also elsewhere on the board
AI15: RIO_AIO_CONN1.23; also elsewhere on the board
AI28: EXPANSION_CONN1.25; also elsewhere on the board
AI29: EXPANSION_CONN1.27; also elsewhere on the board
AI_CDI: RMC_CONN1.128 (DIO59); also elsewhere on the board
AI_CLK: RMC_CONN1.176 (DIO54); also elsewhere on the board
AI_CONVST: RMC_CONN1.122 (DIO60); also elsewhere on the board
AI_CS0: RMC_CONN1.146 (DIO57); also elsewhere on the board
AI_CS1: RMC_CONN1.140 (DIO58); also elsewhere on the board
AI_MISO: RMC_CONN1.164 (DIO55); also elsewhere on the board
AI_MOSI: RMC_CONN1.158 (DIO56); also elsewhere on the board
CAN_HI: CAN_CONN1.7, EXPANSION_CONN1.29, R19.2; also elsewhere on the board
CAN_LO: CAN_CONN1.2, EXPANSION_CONN1.31, R19.1; also elsewhere on the board
DIO0: RMC_CONN1.228 (DIO0); also elsewhere on the board
DIO1: RMC_CONN1.216 (DIO1); also elsewhere on the board
DIO2: RMC_CONN1.210 (DIO2); also elsewhere on the board
DIO3: RMC_CONN1.198 (DIO3); also elsewhere on the board
DIO4: RMC_CONN1.192 (DIO4); also elsewhere on the board
DIO5: RMC_CONN1.180 (DIO5); also elsewhere on the board
DIO6: RMC_CONN1.174 (DIO6); also elsewhere on the board
DIO7: RMC_CONN1.162 (DIO7); also elsewhere on the board
DIO8: RMC_CONN1.156 (DIO8); also elsewhere on the board
DIO9: RMC_CONN1.144 (DIO9); also elsewhere on the board
DIO10: RMC_CONN1.138 (DIO10); also elsewhere on the board
DIO11: RMC_CONN1.126 (DIO11); also elsewhere on the board
DIO12: RMC_CONN1.120 (DIO12)
DIO13: RMC_CONN1.108 (DIO13)
DIO14: RMC_CONN1.102 (DIO14)
DIO15: RMC_CONN1.90 (DIO15)
DIO16: RMC_CONN1.231 (DIO16)
DIO17: RMC_CONN1.225 (DIO17)
DIO18: RMC_CONN1.213 (DIO18); also elsewhere on the board
DIO19: RMC_CONN1.207 (DIO19)
DIO20: RMC_CONN1.195 (DIO20)
DIO21: RMC_CONN1.189 (DIO21)
DIO22: RMC_CONN1.177 (DIO22); also elsewhere on the board
DIO23: RMC_CONN1.171 (DIO23); also elsewhere on the board
DIO24: RMC_CONN1.159 (DIO24); also elsewhere on the board
DIO25: RMC_CONN1.153 (DIO25); also elsewhere on the board
DIO26: RMC_CONN1.141 (DIO26)
DIO27: RMC_CONN1.135 (DIO27)
DIO28: RMC_CONN1.123 (DIO28)
DIO29: RMC_CONN1.117 (DIO29)
DIO30: RMC_CONN1.105 (DIO30)
DIO31: RMC_CONN1.99 (DIO31)
GND: AO_CONN1.5, AO_CONN1.6, C16.2, CAN_CONN1.3, EXPANSION_CONN1.44, EXPANSION_CONN1.45, EXPANSION_CONN1.46, EXPANSION_CONN1.47, EXPANSION_CONN1.48, EXPANSION_CONN1.49, EXPANSION_CONN1.50, RIO_AIO_CONN1.1, RIO_AIO_CONN1.4, RIO_AIO_CONN1.7, RIO_AIO_CONN1.10, RIO_AIO_CONN1.13, RIO_AIO_CONN1.16, RIO_AIO_CONN1.19, RIO_AIO_CONN1.22, RIO_AIO_CONN1.25, RIO_AIO_CONN1.26, RIO_AIO_CONN1.27, RIO_AIO_CONN1.29, RIO_AIO_CONN1.31, RIO_AIO_CONN1.33, RIO_AIO_CONN1.35, RIO_AIO_CONN1.37, RIO_AIO_CONN1.39, RIO_AIO_CONN1.41, RIO_AIO_CONN1.43, RIO_AIO_CONN1.45, RIO_AIO_CONN1.47, RIO_AIO_CONN1.49, RIO_PWR_CONN1.2, RMC_CONN1.26 (GND), RMC_CONN1.30 (GND), RMC_CONN1.36 (GND), RMC_CONN1.39 (GND), RMC_CONN1.41 (GND), RMC_CONN1.44 (GND), RMC_CONN1.47 (GND), RMC_CONN1.57 (GND), RMC_CONN1.62 (GND), RMC_CONN1.65 (GND), RMC_CONN1.75 (GND), RMC_CONN1.78 (GND), RMC_CONN1.80 (GND), RMC_CONN1.83 (GND), RMC_CONN1.93 (GND), RMC_CONN1.96 (GND), RMC_CONN1.98 (GND), RMC_CONN1.101 (GND), RMC_CONN1.111 (GND), RMC_CONN1.114 (GND), RMC_CONN1.116 (GND), RMC_CONN1.119 (GND), RMC_CONN1.129 (GND), RMC_CONN1.132 (GND), RMC_CONN1.134 (GND), RMC_CONN1.137 (GND), RMC_CONN1.147 (GND), RMC_CONN1.150 (GND), RMC_CONN1.152 (GND), RMC_CONN1.155 (GND), RMC_CONN1.165 (GND), RMC_CONN1.168 (GND), RMC_CONN1.170 (GND), RMC_CONN1.173 (GND), RMC_CONN1.183 (GND), RMC_CONN1.186 (GND), RMC_CONN1.188 (GND), RMC_CONN1.191 (GND), RMC_CONN1.201 (GND), RMC_CONN1.204 (GND), RMC_CONN1.206 (GND), RMC_CONN1.209 (GND), RMC_CONN1.219 (GND), RMC_CONN1.222 (GND), RMC_CONN1.224 (GND), RMC_CONN1.227 (GND), RMC_CONN1.237 (GND), RS485_CONN1.1, RST_SW1.2, SP1-6_CONN1.3, SP1-6_CONN1.4, U1.4 (V-), U2.4 (V-); also elsewhere on the board
unnamed: AO_CONN1.1, C16.1, U1.1, U1.2 (-)
unnamed: AO_CONN1.2, U1.6 (-), U1.7
unnamed: AO_CONN1.3, U2.1, U2.2 (-)
unnamed: AO_CONN1.4, U2.6 (-), U2.7
unnamed: EXPANSION_CONN1.1, RMC_CONN1.221 (DIO32)
unnamed: EXPANSION_CONN1.3, RMC_CONN1.215 (DIO33)
unnamed: EXPANSION_CONN1.5, RMC_CONN1.203 (DIO34)
unnamed: EXPANSION_CONN1.7, RMC_CONN1.197 (DIO35)
unnamed: EXPANSION_CONN1.9, RMC_CONN1.185 (DIO36)
unnamed: EXPANSION_CONN1.11, RMC_CONN1.179 (DIO37)
unnamed: EXPANSION_CONN1.13, RMC_CONN1.113 (DIO44)
unnamed: EXPANSION_CONN1.15, RMC_CONN1.107 (DIO45)
unnamed: EXPANSION_CONN1.17, RMC_CONN1.95 (DIO46)
unnamed: EXPANSION_CONN1.19, RMC_CONN1.89 (DIO47)
unnamed: EXPANSION_CONN1.21, RMC_CONN1.230 (DIO48)
unnamed: EXPANSION_CONN1.23, RMC_CONN1.218 (DIO49)
unnamed: HMI_CONN1.1, RS232_CONN1.1
unnamed: HMI_CONN1.2, RS232_CONN1.2
unnamed: HMI_CONN1.3, RS232_CONN1.3
unnamed: HMI_CONN1.4, RS232_CONN1.4
unnamed: HMI_CONN1.5, RS232_CONN1.5
unnamed: HMI_CONN1.6, RS232_CONN1.6
unnamed: HMI_CONN1.7, RS232_CONN1.7
unnamed: HMI_CONN1.8, RS232_CONN1.8
unnamed: HMI_CONN1.9, RS232_CONN1.9
unnamed: HMI_CONN1.10, RS232_CONN1.10
unnamed: PWR_SEL1.2, SP1-6_CONN1.1, SP1-6_CONN1.2
unnamed: RIO_AIO_CONN1.28, U1.3 (+)
unnamed: RIO_AIO_CONN1.30, U1.5 (+)
unnamed: RIO_AIO_CONN1.32, U2.3 (+)
unnamed: RIO_AIO_CONN1.34, U2.5 (+)
unnamed: RMC_CONN1.43 (RST), RST_SW1.1
POS_1_DIAG: RMC_CONN1.167 (DIO38); also elsewhere on the board
POS_1_SPR_1: EXPANSION_CONN1.8; also elsewhere on the board
POS_1_SPR_2: EXPANSION_CONN1.10; also elsewhere on the board
POS_2_DIAG: RMC_CONN1.161 (DIO39); also elsewhere on the board
POS_2_SPR_1: EXPANSION_CONN1.12; also elsewhere on the board
POS_2_SPR_2: EXPANSION_CONN1.14; also elsewhere on the board
POS_3_DIAG: RMC_CONN1.149 (DIO40); also elsewhere on the board
POS_3_SPR_1: EXPANSION_CONN1.16; also elsewhere on the board
POS_3_SPR_2: EXPANSION_CONN1.18; also elsewhere on the board
POS_4_DIAG: RMC_CONN1.143 (DIO41); also elsewhere on the board
POS_4_SPR_1: EXPANSION_CONN1.20; also elsewhere on the board
POS_4_SPR_2: EXPANSION_CONN1.22; also elsewhere on the board
POS_5_DIAG: RMC_CONN1.131 (DIO42); also elsewhere on the board
POS_5_SPR_1: EXPANSION_CONN1.24; also elsewhere on the board
POS_5_SPR_2: EXPANSION_CONN1.26; also elsewhere on the board
POS_6_DIAG: RMC_CONN1.125 (DIO43); also elsewhere on the board
POS_6_SPR_1: EXPANSION_CONN1.28; also elsewhere on the board
POS_6_SPR_2: EXPANSION_CONN1.30; also elsewhere on the board
SPARE_1: EXPANSION_CONN1.33, SP1-6_CONN1.10
SPARE_2: EXPANSION_CONN1.35, SP1-6_CONN1.9
SPARE_3: EXPANSION_CONN1.37, SP1-6_CONN1.8
SPARE_4: EXPANSION_CONN1.39, SP1-6_CONN1.7
SPARE_5: EXPANSION_CONN1.41, SP1-6_CONN1.6
SPARE_6: EXPANSION_CONN1.43, SP1-6_CONN1.5

Notes on the sheet:
SPARE_6
SPARE_1
PS_CMD
GND
SPARE_3
AO3
PRESS_CMD
PWR
AO2
SPARE_4
SPARE_5
SPARE_2

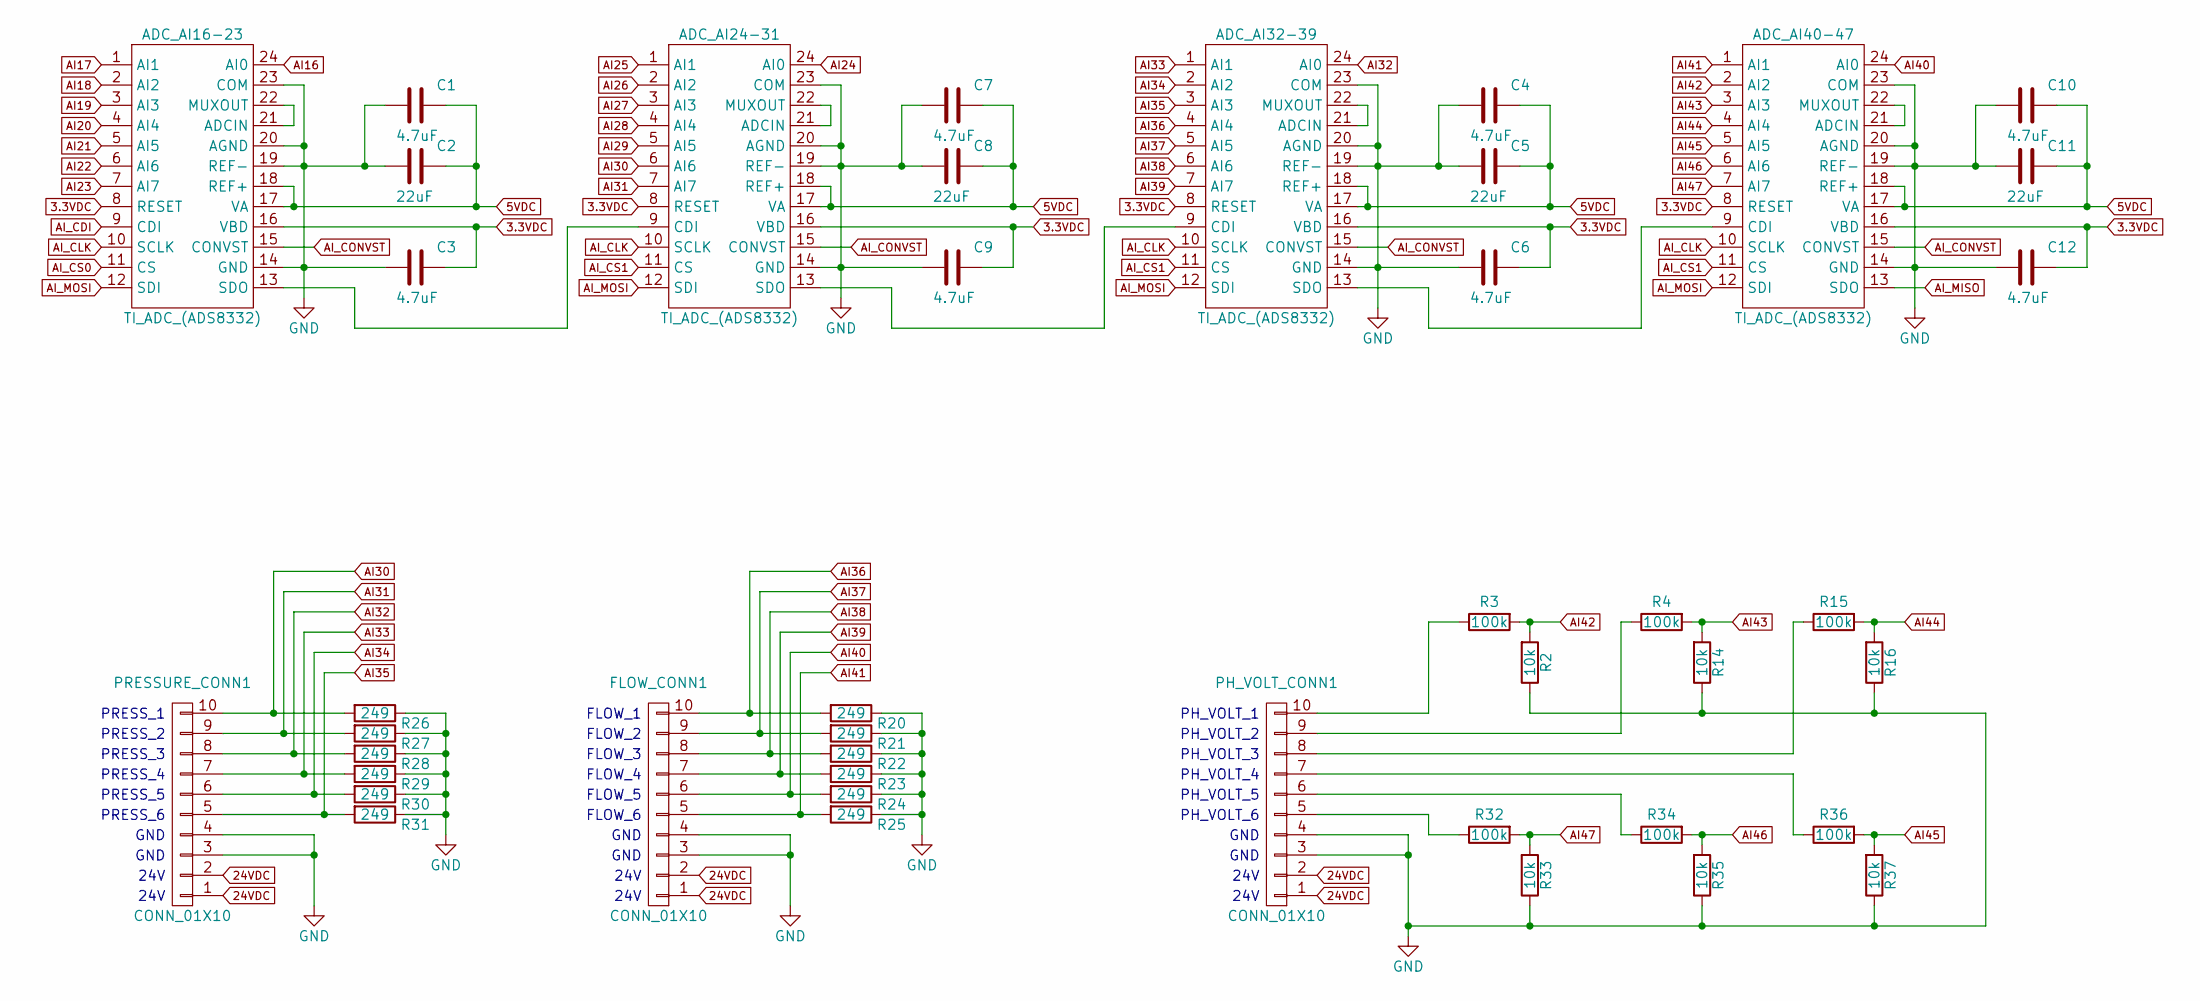
[picture p15: schematic ANALOG_EXPANSION.kicad_sch]

Parts:
ADC_AI16-23, ADC_AI24-31, ADC_AI32-39, ADC_AI40-47: TI_ADC_(ADS8332)
C1, C3, C4, C6, C7, C9, C10, C12: 4.7uF; C_1206_3216Metric
C2, C5, C8, C11: 22uF; C_1206_3216Metric
FLOW_CONN1: CONN_01X10; PHX_TB_HDR_10_POS_STR_(1755817)
PH_VOLT_CONN1: CONN_01X10; PHX_TB_HDR_10_POS_STR_(1755817)
PRESSURE_CONN1: CONN_01X10; PHX_TB_HDR_10_POS_STR_(1755817)
R2, R14, R16, R33, R35, R37: 10k; R_1206_3216Metric
R3, R4, R15, R32, R34, R36: 100k; R_1206_3216Metric
R20, R21, R22, R23, R24, R25, R26, R27, R28, R29, R30, R31: 249; R_1206_3216Metric

Connections:
3.3VDC: ADC_AI16-23.8 (RESET), ADC_AI16-23.16 (VBD), ADC_AI24-31.8 (RESET), ADC_AI24-31.16 (VBD), ADC_AI32-39.8 (RESET), ADC_AI32-39.16 (VBD), ADC_AI40-47.8 (RESET), ADC_AI40-47.16 (VBD), C3.1, C6.1, C9.1, C12.1; also elsewhere on the board
5VDC: ADC_AI16-23.17 (VA), ADC_AI16-23.18 (REF+), ADC_AI24-31.17 (VA), ADC_AI24-31.18 (REF+), ADC_AI32-39.17 (VA), ADC_AI32-39.18 (REF+), ADC_AI40-47.17 (VA), ADC_AI40-47.18 (REF+), C1.1, C2.1, C4.1, C5.1, C7.1, C8.1, C10.1, C11.1; also elsewhere on the board
24VDC: FLOW_CONN1.1, FLOW_CONN1.2, PH_VOLT_CONN1.1, PH_VOLT_CONN1.2, PRESSURE_CONN1.1, PRESSURE_CONN1.2; also elsewhere on the board
AI16: ADC_AI16-23.24 (AI0); also elsewhere on the board
AI17: ADC_AI16-23.1 (AI1); also elsewhere on the board
AI18: ADC_AI16-23.2 (AI2); also elsewhere on the board
AI19: ADC_AI16-23.3 (AI3); also elsewhere on the board
AI20: ADC_AI16-23.4 (AI4); also elsewhere on the board
AI21: ADC_AI16-23.5 (AI5); also elsewhere on the board
AI22: ADC_AI16-23.6 (AI6); also elsewhere on the board
AI23: ADC_AI16-23.7 (AI7); also elsewhere on the board
AI24: ADC_AI24-31.24 (AI0); also elsewhere on the board
AI25: ADC_AI24-31.1 (AI1); also elsewhere on the board
AI26: ADC_AI24-31.2 (AI2); also elsewhere on the board
AI27: ADC_AI24-31.3 (AI3); also elsewhere on the board
AI28: ADC_AI24-31.4 (AI4); also elsewhere on the board
AI29: ADC_AI24-31.5 (AI5); also elsewhere on the board
AI30: ADC_AI24-31.6 (AI6), PRESSURE_CONN1.10, R26.2
AI31: ADC_AI24-31.7 (AI7), PRESSURE_CONN1.9, R27.2
AI32: ADC_AI32-39.24 (AI0), PRESSURE_CONN1.8, R28.2
AI33: ADC_AI32-39.1 (AI1), PRESSURE_CONN1.7, R29.2
AI34: ADC_AI32-39.2 (AI2), PRESSURE_CONN1.6, R30.2
AI35: ADC_AI32-39.3 (AI3), PRESSURE_CONN1.5, R31.2
AI36: ADC_AI32-39.4 (AI4), FLOW_CONN1.10, R20.2
AI37: ADC_AI32-39.5 (AI5), FLOW_CONN1.9, R21.2
AI38: ADC_AI32-39.6 (AI6), FLOW_CONN1.8, R22.2
AI39: ADC_AI32-39.7 (AI7), FLOW_CONN1.7, R23.2
AI40: ADC_AI40-47.24 (AI0), FLOW_CONN1.6, R24.2
AI41: ADC_AI40-47.1 (AI1), FLOW_CONN1.5, R25.2
AI42: ADC_AI40-47.2 (AI2), R2.2, R3.2
AI43: ADC_AI40-47.3 (AI3), R4.2, R14.2
AI44: ADC_AI40-47.4 (AI4), R15.2, R16.2
AI45: ADC_AI40-47.5 (AI5), R36.2, R37.2
AI46: ADC_AI40-47.6 (AI6), R34.2, R35.2
AI47: ADC_AI40-47.7 (AI7), R32.2, R33.2
AI_CDI: ADC_AI16-23.9 (CDI); also elsewhere on the board
AI_CLK: ADC_AI16-23.10 (SCLK), ADC_AI24-31.10 (SCLK), ADC_AI32-39.10 (SCLK), ADC_AI40-47.10 (SCLK); also elsewhere on the board
AI_CONVST: ADC_AI16-23.15 (CONVST), ADC_AI24-31.15 (CONVST), ADC_AI32-39.15 (CONVST), ADC_AI40-47.15 (CONVST); also elsewhere on the board
AI_CS0: ADC_AI16-23.11 (CS); also elsewhere on the board
AI_CS1: ADC_AI24-31.11 (CS), ADC_AI32-39.11 (CS), ADC_AI40-47.11 (CS); also elsewhere on the board
AI_MISO: ADC_AI40-47.13 (SDO); also elsewhere on the board
AI_MOSI: ADC_AI16-23.12 (SDI), ADC_AI24-31.12 (SDI), ADC_AI32-39.12 (SDI), ADC_AI40-47.12 (SDI); also elsewhere on the board
GND: ADC_AI16-23.14 (GND), ADC_AI16-23.19 (REF-), ADC_AI16-23.20 (AGND), ADC_AI16-23.23 (COM), ADC_AI24-31.14 (GND), ADC_AI24-31.19 (REF-), ADC_AI24-31.20 (AGND), ADC_AI24-31.23 (COM), ADC_AI32-39.14 (GND), ADC_AI32-39.19 (REF-), ADC_AI32-39.20 (AGND), ADC_AI32-39.23 (COM), ADC_AI40-47.14 (GND), ADC_AI40-47.19 (REF-), ADC_AI40-47.20 (AGND), ADC_AI40-47.23 (COM), C1.2, C2.2, C3.2, C4.2, C5.2, C6.2, C7.2, C8.2, C9.2, C10.2, C11.2, C12.2, FLOW_CONN1.3, FLOW_CONN1.4, PH_VOLT_CONN1.3, PH_VOLT_CONN1.4, PRESSURE_CONN1.3, PRESSURE_CONN1.4, R2.1, R14.1, R16.1, R20.1, R21.1, R22.1, R23.1, R24.1, R25.1, R26.1, R27.1, R28.1, R29.1, R30.1, R31.1, R33.1, R35.1, R37.1; also elsewhere on the board
unnamed: ADC_AI16-23.21 (ADCIN), ADC_AI16-23.22 (MUXOUT)
unnamed: ADC_AI16-23.13 (SDO), ADC_AI24-31.9 (CDI)
unnamed: ADC_AI24-31.21 (ADCIN), ADC_AI24-31.22 (MUXOUT)
unnamed: ADC_AI24-31.13 (SDO), ADC_AI32-39.9 (CDI)
unnamed: ADC_AI32-39.21 (ADCIN), ADC_AI32-39.22 (MUXOUT)
unnamed: ADC_AI32-39.13 (SDO), ADC_AI40-47.9 (CDI)
unnamed: ADC_AI40-47.21 (ADCIN), ADC_AI40-47.22 (MUXOUT)
unnamed: PH_VOLT_CONN1.5, R32.1
unnamed: PH_VOLT_CONN1.6, R34.1
unnamed: PH_VOLT_CONN1.7, R36.1
unnamed: PH_VOLT_CONN1.8, R15.1
unnamed: PH_VOLT_CONN1.9, R4.1
unnamed: PH_VOLT_CONN1.10, R3.1

Notes on the sheet:
FLOW_1
PRESS_6
FLOW_3
PH_VOLT_2
PH_VOLT_5
PRESS_1
24V
PH_VOLT_6
PRESS_4
PRESS_2
PH_VOLT_3
FLOW_5
FLOW_4
PRESS_3
PRESS_5
GND
PH_VOLT_4
FLOW_2
FLOW_6
PH_VOLT_1
