titetil/smart-tank-pcb/Motherboard/Smart Tank Motherboard.kicad_pcb

## KiCad design Motherboard/Smart Tank Motherboard.kicad_pcb (continued)

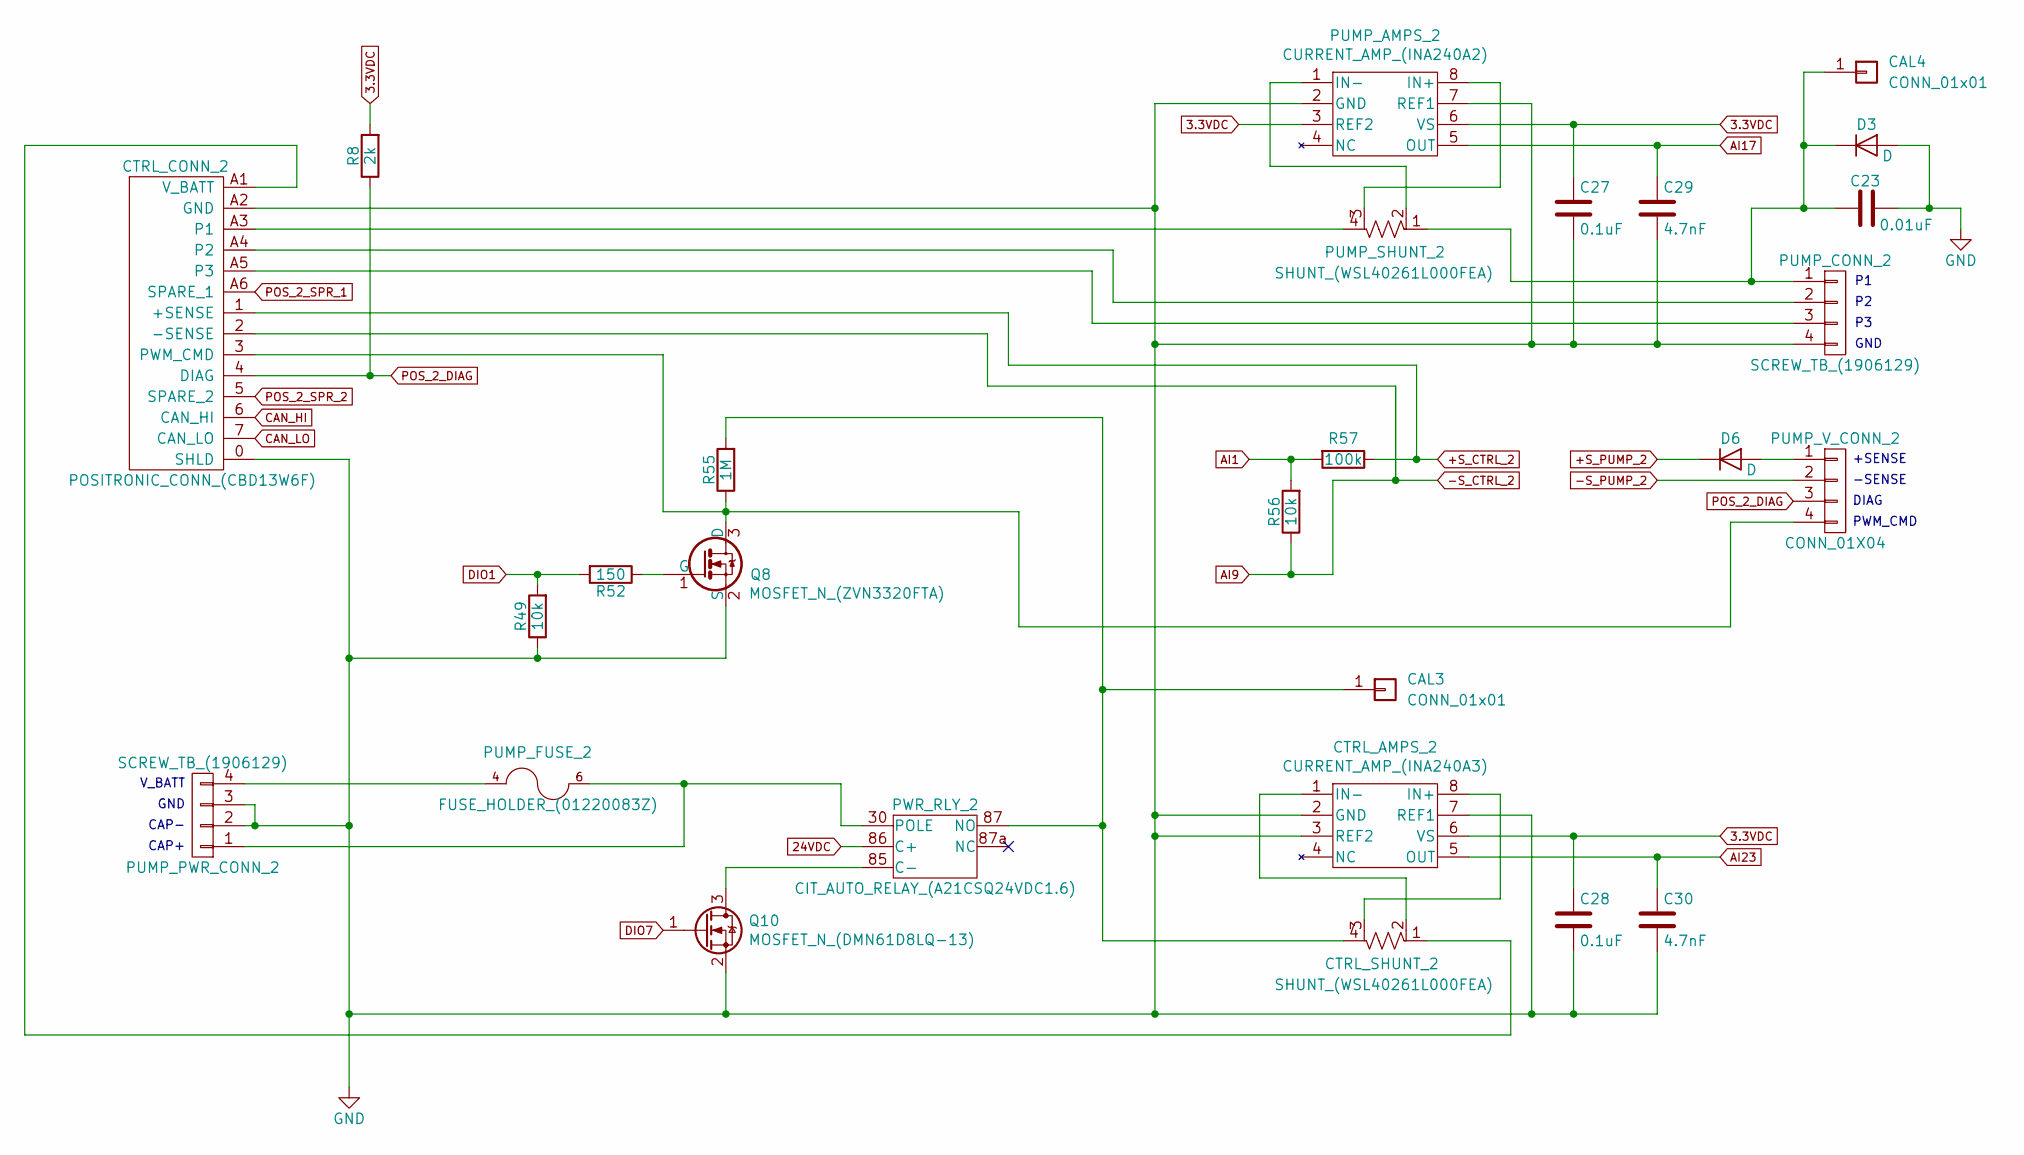
[picture p16: schematic POSITION_2.kicad_sch]

Parts:
C23: 0.01uF; C_1206_3216Metric
C27, C28: 0.1uF; C_1206_3216Metric
C29, C30: 4.7nF; C_1206_3216Metric
CAL3, CAL4: CONN_01x01; FEMALE_SPADE_QC_(TE_63969-1)
CTRL_AMPS_2: CURRENT_AMP_(INA240A3); SOIC-8_3.9x4.9mm_P1.27mm
CTRL_CONN_2: POSITRONIC_CONN_(CBD13W6F); POSITRONIC_D-SUB_(CBD13W6F35S600X_AA)
CTRL_SHUNT_2: SHUNT_(WSL40261L000FEA)
D3, D6: D; D_SMA
PUMP_AMPS_2: CURRENT_AMP_(INA240A2); SOIC-8_3.9x4.9mm_P1.27mm
PUMP_CONN_2: SCREW_TB_(1906129); PHNX_TB_SCREW_4_POS_(1906129)
PUMP_FUSE_2: FUSE_HOLDER_(01220083Z)
PUMP_PWR_CONN_2: SCREW_TB_(1906129); PHNX_TB_SCREW_4_POS_(1906129)
PUMP_SHUNT_2: SHUNT_(WSL40261L000FEA)
PUMP_V_CONN_2: CONN_01X04; PHX_TB_HDR_4_POS_STR_(1755752)
PWR_RLY_2: CIT_AUTO_RELAY_(A21CSQ24VDC1.6); TE_AUTO_RELAY_SOCKET_(VCF4-1000)
Q8: MOSFET_N_(ZVN3320FTA); SOT-23
Q10: MOSFET_N_(DMN61D8LQ-13); SOT-23
R8: 2k; R_1206_3216Metric
R49, R56: 10k; R_1206_3216Metric
R52: 150; R_1206_3216Metric
R55: 1M; R_1206_3216Metric
R57: 100k; R_1206_3216Metric

Connections:
3.3VDC: C27.1, C28.1, CTRL_AMPS_2.6 (VS), PUMP_AMPS_2.3 (REF2), PUMP_AMPS_2.6 (VS), R8.2; also elsewhere on the board
24VDC: PWR_RLY_2.86 (C+); also elsewhere on the board
+S_CTRL_2: CTRL_CONN_2.1 (+SENSE), R57.1; also elsewhere on the board
+S_PUMP_2: D6.1 (K); also elsewhere on the board
-S_CTRL_2: CTRL_CONN_2.2 (-SENSE), R56.1; also elsewhere on the board
-S_PUMP_2: PUMP_V_CONN_2.2; also elsewhere on the board
AI1: R56.2, R57.2; also elsewhere on the board
AI17: C29.1, PUMP_AMPS_2.5 (OUT); also elsewhere on the board
AI23: C30.1, CTRL_AMPS_2.5 (OUT); also elsewhere on the board
CAN_HI: CTRL_CONN_2.6 (CAN_HI); also elsewhere on the board
CAN_LO: CTRL_CONN_2.7 (CAN_LO); also elsewhere on the board
DIO1: R49.2, R52.2; also elsewhere on the board
DIO7: Q10.1 (G); also elsewhere on the board
GND: C23.2, C27.2, C28.2, C29.2, C30.2, CTRL_AMPS_2.2 (GND), CTRL_AMPS_2.3 (REF2), CTRL_AMPS_2.7 (REF1), CTRL_CONN_2.0 (SHLD), CTRL_CONN_2.A2 (GND), D3.2 (A), PUMP_AMPS_2.2 (GND), PUMP_AMPS_2.7 (REF1), PUMP_CONN_2.4, PUMP_PWR_CONN_2.2, PUMP_PWR_CONN_2.3, Q8.2 (S), Q10.2 (S), R49.1; also elsewhere on the board
unnamed: CAL3.1, CTRL_SHUNT_2.4, PWR_RLY_2.87 (NO), R55.2
unnamed: C23.1, CAL4.1, D3.1 (K), PUMP_CONN_2.1, PUMP_SHUNT_2.1
unnamed: CTRL_AMPS_2.8 (IN+), CTRL_SHUNT_2.3
unnamed: CTRL_AMPS_2.1 (IN-), CTRL_SHUNT_2.2
unnamed: CTRL_CONN_2.A3 (P1), PUMP_SHUNT_2.4
unnamed: CTRL_CONN_2.A4 (P2), PUMP_CONN_2.2
unnamed: CTRL_CONN_2.A5 (P3), PUMP_CONN_2.3
unnamed: CTRL_CONN_2.3 (PWM_CMD), PUMP_V_CONN_2.4, Q8.3 (D), R55.1
unnamed: CTRL_CONN_2.A1 (V_BATT), CTRL_SHUNT_2.1
unnamed: D6.2 (A), PUMP_V_CONN_2.1
unnamed: PUMP_AMPS_2.8 (IN+), PUMP_SHUNT_2.3
unnamed: PUMP_AMPS_2.1 (IN-), PUMP_SHUNT_2.2
unnamed: PUMP_FUSE_2.6, PUMP_FUSE_2.7, PUMP_PWR_CONN_2.1, PWR_RLY_2.30 (POLE)
unnamed: PUMP_FUSE_2.4, PUMP_FUSE_2.5, PUMP_PWR_CONN_2.4
unnamed: PWR_RLY_2.85 (C-), Q10.3 (D)
unnamed: Q8.1 (G), R52.1
POS_2_DIAG: CTRL_CONN_2.4 (DIAG), PUMP_V_CONN_2.3, R8.1; also elsewhere on the board
POS_2_SPR_1: CTRL_CONN_2.A6 (SPARE_1); also elsewhere on the board
POS_2_SPR_2: CTRL_CONN_2.5 (SPARE_2); also elsewhere on the board

Notes on the sheet:
V_BATT
+SENSE
GND
CAP+
DIAG
GND
-SENSE
PWM_CMD
CAP-

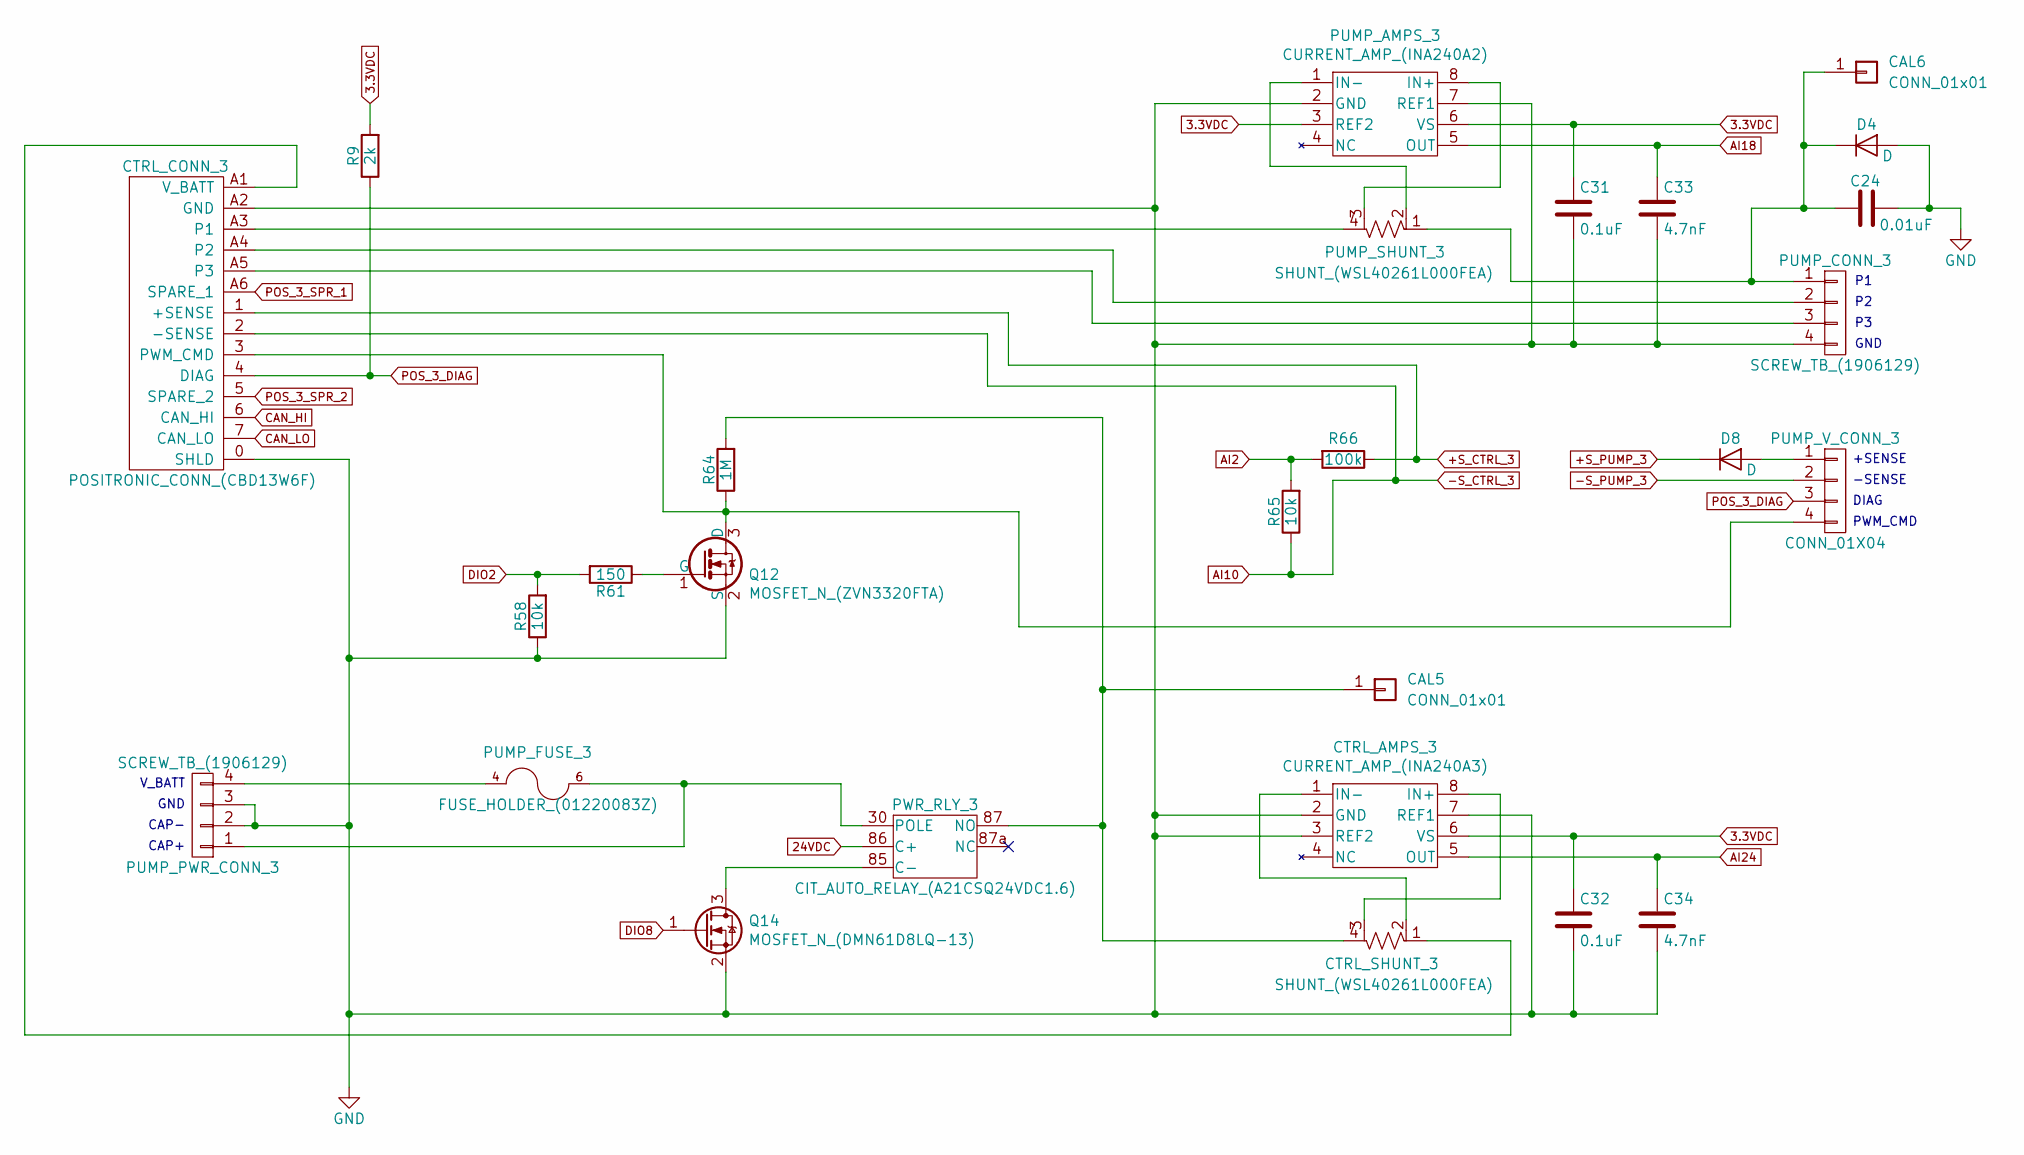
[picture p17: schematic POSITION_3.kicad_sch]

Parts:
C24: 0.01uF; C_1206_3216Metric
C31, C32: 0.1uF; C_1206_3216Metric
C33, C34: 4.7nF; C_1206_3216Metric
CAL5, CAL6: CONN_01x01; FEMALE_SPADE_QC_(TE_63969-1)
CTRL_AMPS_3: CURRENT_AMP_(INA240A3); SOIC-8_3.9x4.9mm_P1.27mm
CTRL_CONN_3: POSITRONIC_CONN_(CBD13W6F); POSITRONIC_D-SUB_(CBD13W6F35S600X_AA)
CTRL_SHUNT_3: SHUNT_(WSL40261L000FEA)
D4, D8: D; D_SMA
PUMP_AMPS_3: CURRENT_AMP_(INA240A2); SOIC-8_3.9x4.9mm_P1.27mm
PUMP_CONN_3: SCREW_TB_(1906129); PHNX_TB_SCREW_4_POS_(1906129)
PUMP_FUSE_3: FUSE_HOLDER_(01220083Z)
PUMP_PWR_CONN_3: SCREW_TB_(1906129); PHNX_TB_SCREW_4_POS_(1906129)
PUMP_SHUNT_3: SHUNT_(WSL40261L000FEA)
PUMP_V_CONN_3: CONN_01X04; PHX_TB_HDR_4_POS_STR_(1755752)
PWR_RLY_3: CIT_AUTO_RELAY_(A21CSQ24VDC1.6); TE_AUTO_RELAY_SOCKET_(VCF4-1000)
Q12: MOSFET_N_(ZVN3320FTA); SOT-23
Q14: MOSFET_N_(DMN61D8LQ-13); SOT-23
R9: 2k; R_1206_3216Metric
R58, R65: 10k; R_1206_3216Metric
R61: 150; R_1206_3216Metric
R64: 1M; R_1206_3216Metric
R66: 100k; R_1206_3216Metric

Connections:
3.3VDC: C31.1, C32.1, CTRL_AMPS_3.6 (VS), PUMP_AMPS_3.3 (REF2), PUMP_AMPS_3.6 (VS), R9.2; also elsewhere on the board
24VDC: PWR_RLY_3.86 (C+); also elsewhere on the board
+S_CTRL_3: CTRL_CONN_3.1 (+SENSE), R66.1; also elsewhere on the board
+S_PUMP_3: D8.1 (K); also elsewhere on the board
-S_CTRL_3: CTRL_CONN_3.2 (-SENSE), R65.1; also elsewhere on the board
-S_PUMP_3: PUMP_V_CONN_3.2; also elsewhere on the board
AI2: R65.2, R66.2; also elsewhere on the board
AI18: C33.1, PUMP_AMPS_3.5 (OUT); also elsewhere on the board
AI24: C34.1, CTRL_AMPS_3.5 (OUT); also elsewhere on the board
CAN_HI: CTRL_CONN_3.6 (CAN_HI); also elsewhere on the board
CAN_LO: CTRL_CONN_3.7 (CAN_LO); also elsewhere on the board
DIO2: R58.2, R61.2; also elsewhere on the board
DIO8: Q14.1 (G); also elsewhere on the board
GND: C24.2, C31.2, C32.2, C33.2, C34.2, CTRL_AMPS_3.2 (GND), CTRL_AMPS_3.3 (REF2), CTRL_AMPS_3.7 (REF1), CTRL_CONN_3.0 (SHLD), CTRL_CONN_3.A2 (GND), D4.2 (A), PUMP_AMPS_3.2 (GND), PUMP_AMPS_3.7 (REF1), PUMP_CONN_3.4, PUMP_PWR_CONN_3.2, PUMP_PWR_CONN_3.3, Q12.2 (S), Q14.2 (S), R58.1; also elsewhere on the board
unnamed: CAL5.1, CTRL_SHUNT_3.4, PWR_RLY_3.87 (NO), R64.2
unnamed: C24.1, CAL6.1, D4.1 (K), PUMP_CONN_3.1, PUMP_SHUNT_3.1
unnamed: CTRL_AMPS_3.8 (IN+), CTRL_SHUNT_3.3
unnamed: CTRL_AMPS_3.1 (IN-), CTRL_SHUNT_3.2
unnamed: CTRL_CONN_3.A3 (P1), PUMP_SHUNT_3.4
unnamed: CTRL_CONN_3.A4 (P2), PUMP_CONN_3.2
unnamed: CTRL_CONN_3.A5 (P3), PUMP_CONN_3.3
unnamed: CTRL_CONN_3.3 (PWM_CMD), PUMP_V_CONN_3.4, Q12.3 (D), R64.1
unnamed: CTRL_CONN_3.A1 (V_BATT), CTRL_SHUNT_3.1
unnamed: D8.2 (A), PUMP_V_CONN_3.1
unnamed: PUMP_AMPS_3.8 (IN+), PUMP_SHUNT_3.3
unnamed: PUMP_AMPS_3.1 (IN-), PUMP_SHUNT_3.2
unnamed: PUMP_FUSE_3.6, PUMP_FUSE_3.7, PUMP_PWR_CONN_3.1, PWR_RLY_3.30 (POLE)
unnamed: PUMP_FUSE_3.4, PUMP_FUSE_3.5, PUMP_PWR_CONN_3.4
unnamed: PWR_RLY_3.85 (C-), Q14.3 (D)
unnamed: Q12.1 (G), R61.1
POS_3_DIAG: CTRL_CONN_3.4 (DIAG), PUMP_V_CONN_3.3, R9.1; also elsewhere on the board
POS_3_SPR_1: CTRL_CONN_3.A6 (SPARE_1); also elsewhere on the board
POS_3_SPR_2: CTRL_CONN_3.5 (SPARE_2); also elsewhere on the board

Notes on the sheet:
CAP-
CAP+
-SENSE
V_BATT
PWM_CMD
DIAG
+SENSE
GND
GND

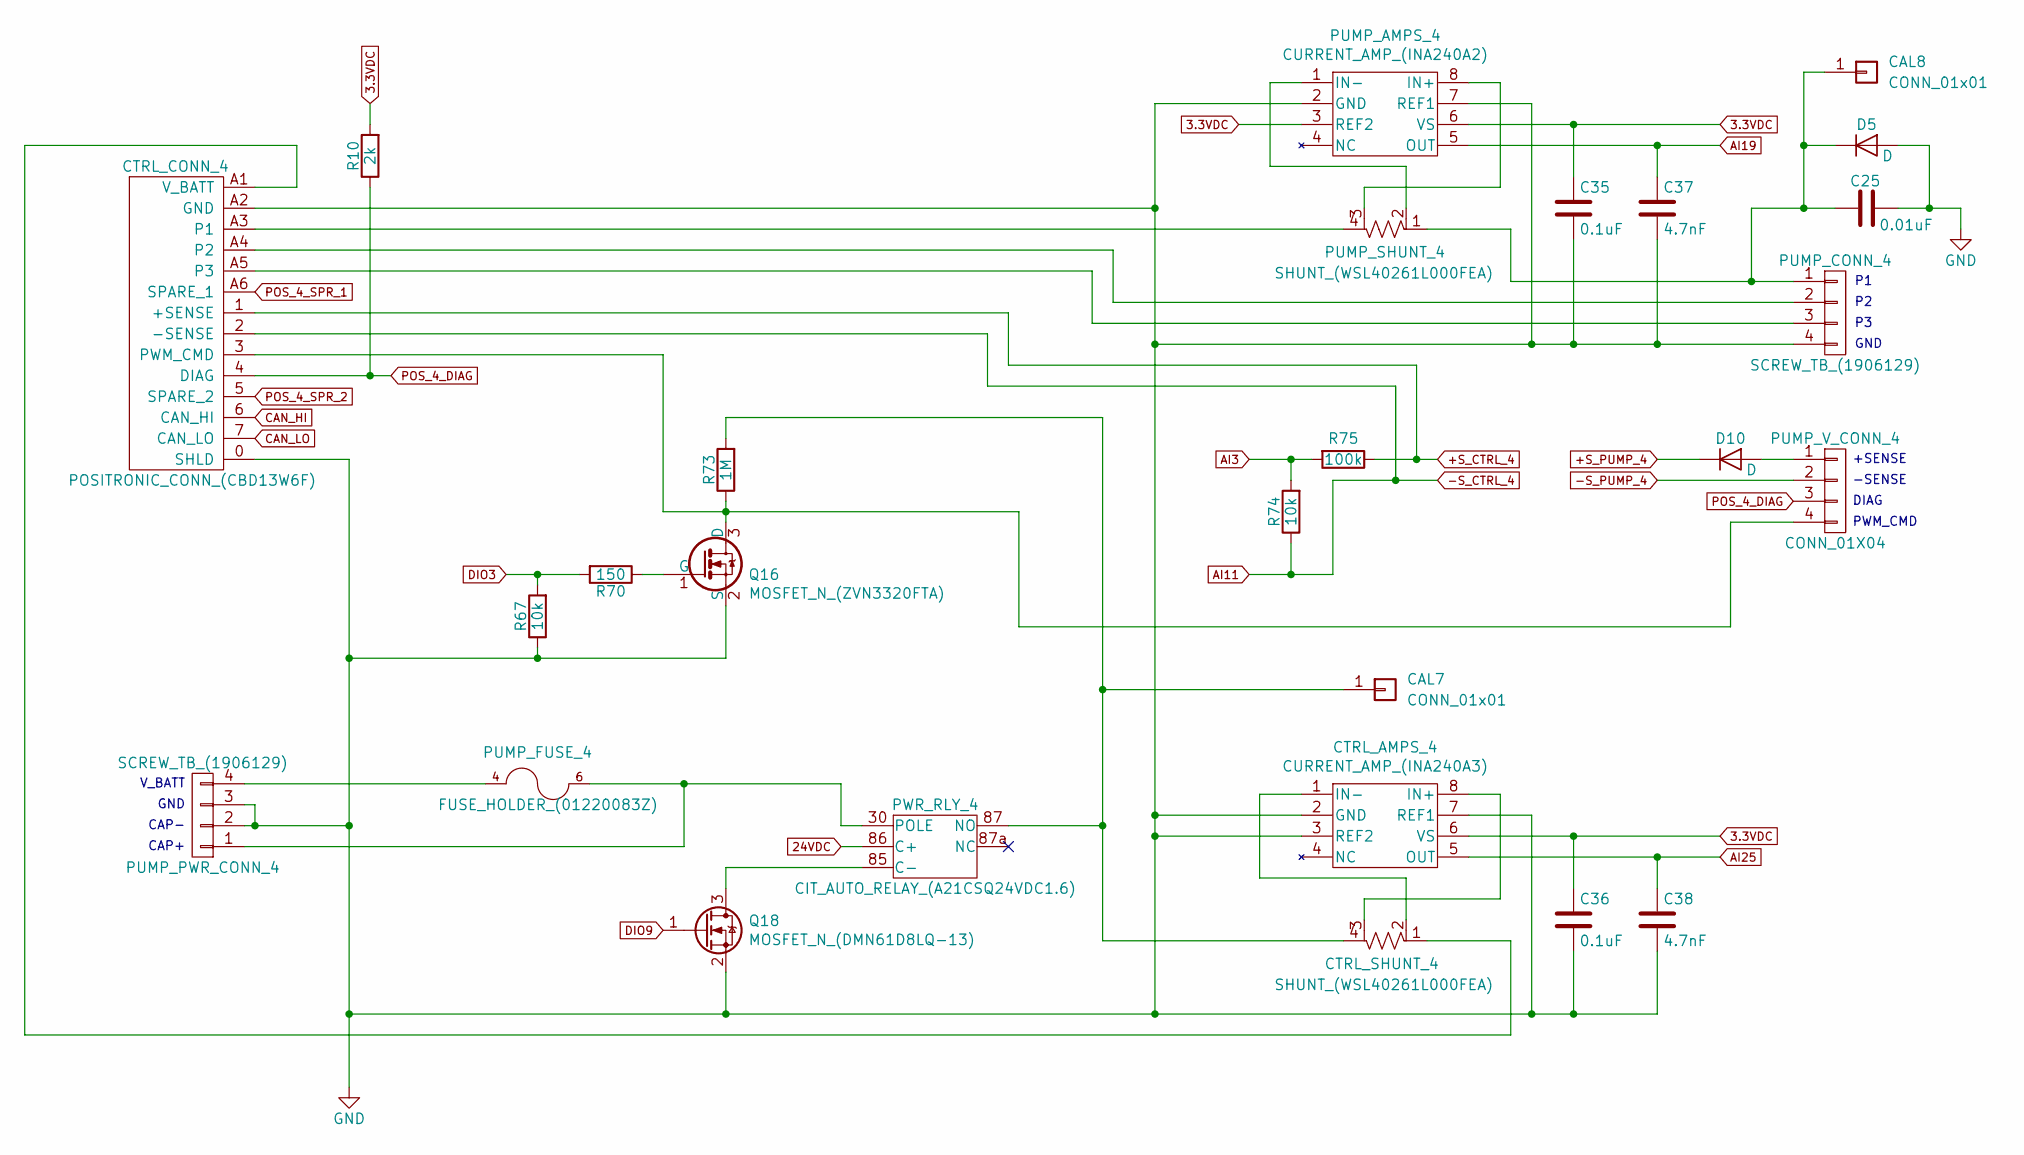
[picture p18: schematic POSITION_4.kicad_sch]

Parts:
C25: 0.01uF; C_1206_3216Metric
C35, C36: 0.1uF; C_1206_3216Metric
C37, C38: 4.7nF; C_1206_3216Metric
CAL7, CAL8: CONN_01x01; FEMALE_SPADE_QC_(TE_63969-1)
CTRL_AMPS_4: CURRENT_AMP_(INA240A3); SOIC-8_3.9x4.9mm_P1.27mm
CTRL_CONN_4: POSITRONIC_CONN_(CBD13W6F); POSITRONIC_D-SUB_(CBD13W6F35S600X_AA)
CTRL_SHUNT_4: SHUNT_(WSL40261L000FEA)
D5, D10: D; D_SMA
PUMP_AMPS_4: CURRENT_AMP_(INA240A2); SOIC-8_3.9x4.9mm_P1.27mm
PUMP_CONN_4: SCREW_TB_(1906129); PHNX_TB_SCREW_4_POS_(1906129)
PUMP_FUSE_4: FUSE_HOLDER_(01220083Z)
PUMP_PWR_CONN_4: SCREW_TB_(1906129); PHNX_TB_SCREW_4_POS_(1906129)
PUMP_SHUNT_4: SHUNT_(WSL40261L000FEA)
PUMP_V_CONN_4: CONN_01X04; PHX_TB_HDR_4_POS_STR_(1755752)
PWR_RLY_4: CIT_AUTO_RELAY_(A21CSQ24VDC1.6); TE_AUTO_RELAY_SOCKET_(VCF4-1000)
Q16: MOSFET_N_(ZVN3320FTA); SOT-23
Q18: MOSFET_N_(DMN61D8LQ-13); SOT-23
R10: 2k; R_1206_3216Metric
R67, R74: 10k; R_1206_3216Metric
R70: 150; R_1206_3216Metric
R73: 1M; R_1206_3216Metric
R75: 100k; R_1206_3216Metric

Connections:
3.3VDC: C35.1, C36.1, CTRL_AMPS_4.6 (VS), PUMP_AMPS_4.3 (REF2), PUMP_AMPS_4.6 (VS), R10.2; also elsewhere on the board
24VDC: PWR_RLY_4.86 (C+); also elsewhere on the board
+S_CTRL_4: CTRL_CONN_4.1 (+SENSE), R75.1; also elsewhere on the board
+S_PUMP_4: D10.1 (K); also elsewhere on the board
-S_CTRL_4: CTRL_CONN_4.2 (-SENSE), R74.1; also elsewhere on the board
-S_PUMP_4: PUMP_V_CONN_4.2; also elsewhere on the board
AI3: R74.2, R75.2; also elsewhere on the board
AI19: C37.1, PUMP_AMPS_4.5 (OUT); also elsewhere on the board
AI25: C38.1, CTRL_AMPS_4.5 (OUT); also elsewhere on the board
CAN_HI: CTRL_CONN_4.6 (CAN_HI); also elsewhere on the board
CAN_LO: CTRL_CONN_4.7 (CAN_LO); also elsewhere on the board
DIO3: R67.2, R70.2; also elsewhere on the board
DIO9: Q18.1 (G); also elsewhere on the board
GND: C25.2, C35.2, C36.2, C37.2, C38.2, CTRL_AMPS_4.2 (GND), CTRL_AMPS_4.3 (REF2), CTRL_AMPS_4.7 (REF1), CTRL_CONN_4.0 (SHLD), CTRL_CONN_4.A2 (GND), D5.2 (A), PUMP_AMPS_4.2 (GND), PUMP_AMPS_4.7 (REF1), PUMP_CONN_4.4, PUMP_PWR_CONN_4.2, PUMP_PWR_CONN_4.3, Q16.2 (S), Q18.2 (S), R67.1; also elsewhere on the board
unnamed: CAL7.1, CTRL_SHUNT_4.4, PWR_RLY_4.87 (NO), R73.2
unnamed: C25.1, CAL8.1, D5.1 (K), PUMP_CONN_4.1, PUMP_SHUNT_4.1
unnamed: CTRL_AMPS_4.8 (IN+), CTRL_SHUNT_4.3
unnamed: CTRL_AMPS_4.1 (IN-), CTRL_SHUNT_4.2
unnamed: CTRL_CONN_4.A3 (P1), PUMP_SHUNT_4.4
unnamed: CTRL_CONN_4.A4 (P2), PUMP_CONN_4.2
unnamed: CTRL_CONN_4.A5 (P3), PUMP_CONN_4.3
unnamed: CTRL_CONN_4.3 (PWM_CMD), PUMP_V_CONN_4.4, Q16.3 (D), R73.1
unnamed: CTRL_CONN_4.A1 (V_BATT), CTRL_SHUNT_4.1
unnamed: D10.2 (A), PUMP_V_CONN_4.1
unnamed: PUMP_AMPS_4.8 (IN+), PUMP_SHUNT_4.3
unnamed: PUMP_AMPS_4.1 (IN-), PUMP_SHUNT_4.2
unnamed: PUMP_FUSE_4.6, PUMP_FUSE_4.7, PUMP_PWR_CONN_4.1, PWR_RLY_4.30 (POLE)
unnamed: PUMP_FUSE_4.4, PUMP_FUSE_4.5, PUMP_PWR_CONN_4.4
unnamed: PWR_RLY_4.85 (C-), Q18.3 (D)
unnamed: Q16.1 (G), R70.1
POS_4_DIAG: CTRL_CONN_4.4 (DIAG), PUMP_V_CONN_4.3, R10.1; also elsewhere on the board
POS_4_SPR_1: CTRL_CONN_4.A6 (SPARE_1); also elsewhere on the board
POS_4_SPR_2: CTRL_CONN_4.5 (SPARE_2); also elsewhere on the board

Notes on the sheet:
PWM_CMD
CAP-
DIAG
CAP+
GND
GND
V_BATT
-SENSE
+SENSE

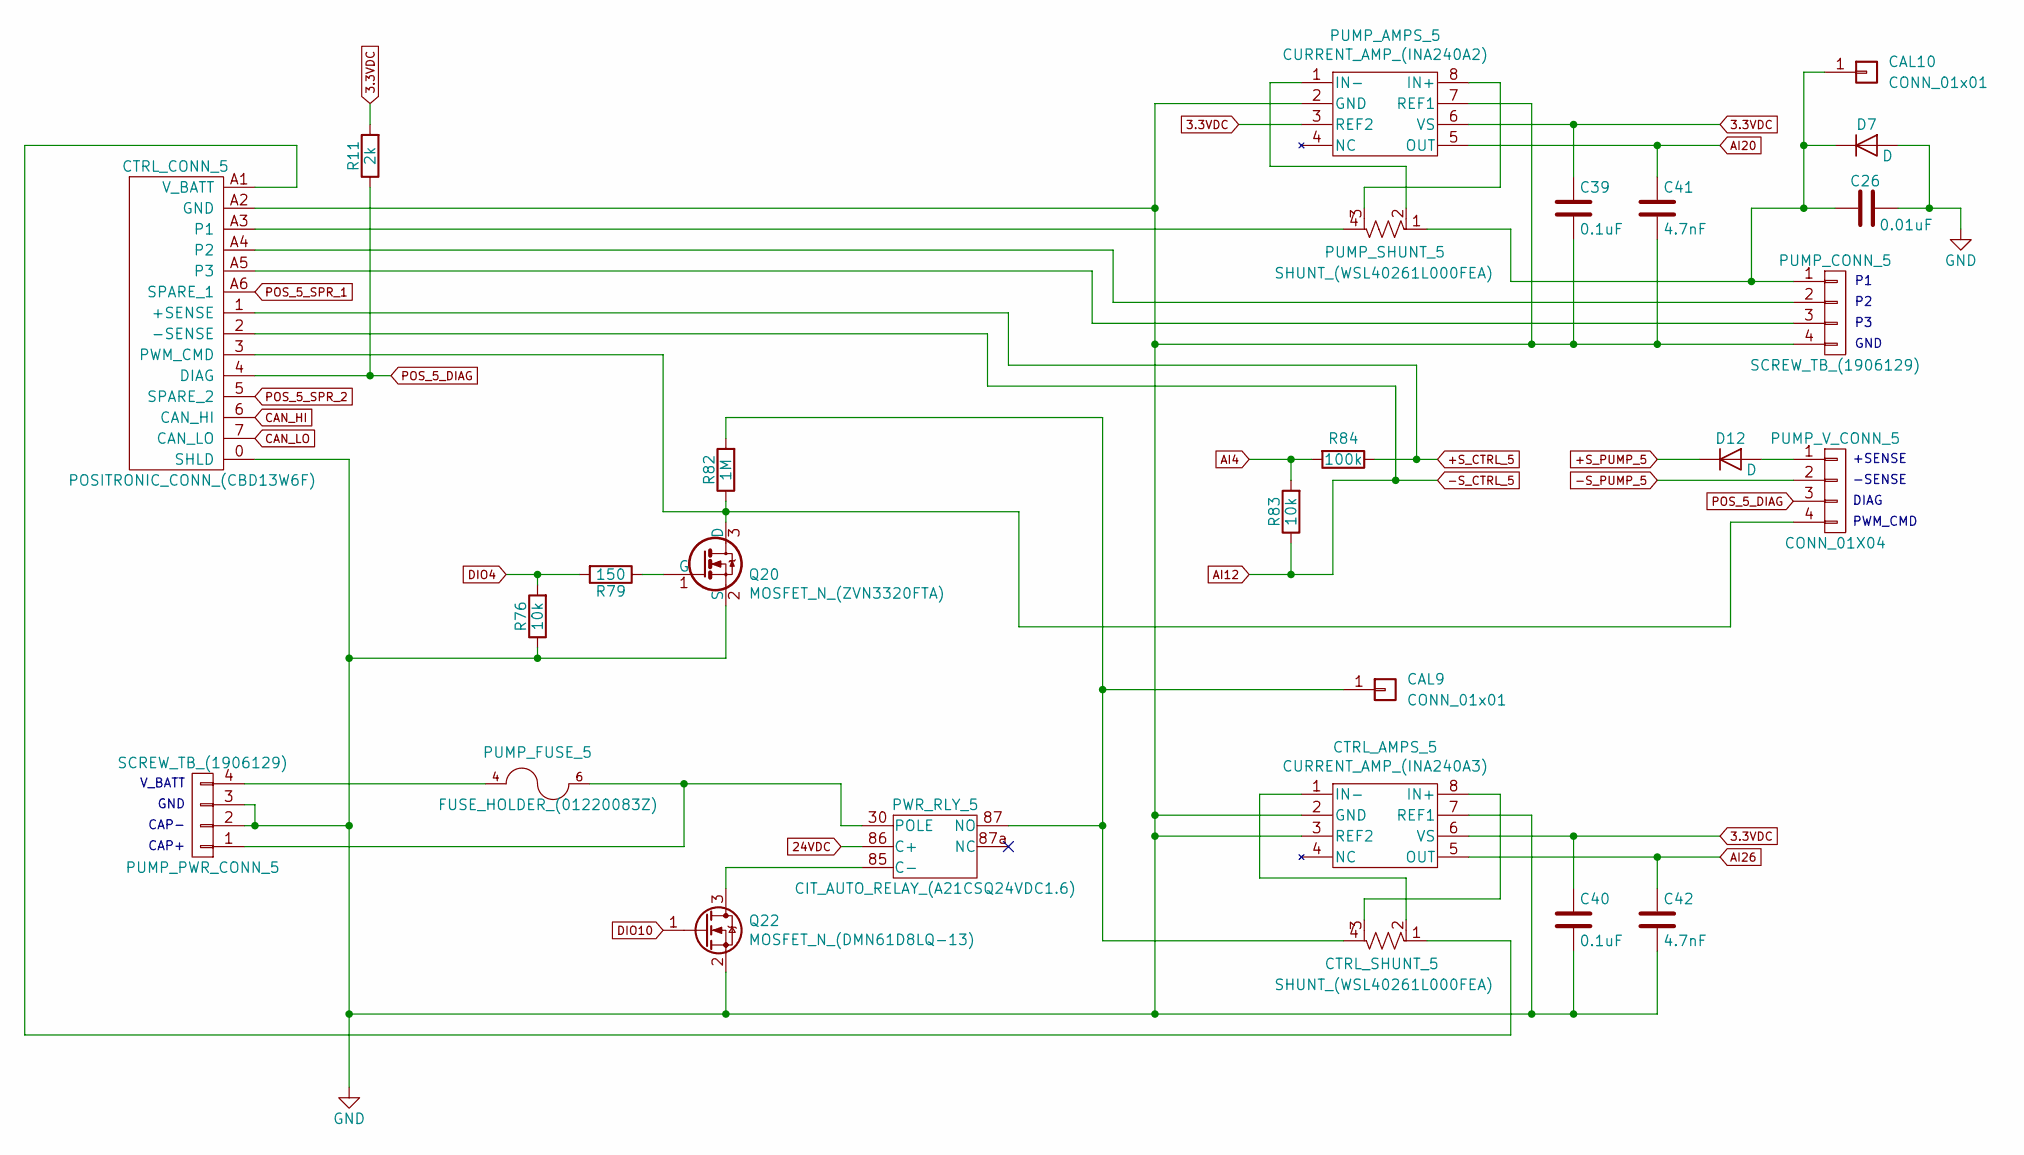
[picture p19: schematic POSITION_5.kicad_sch]

Parts:
C26: 0.01uF; C_1206_3216Metric
C39, C40: 0.1uF; C_1206_3216Metric
C41, C42: 4.7nF; C_1206_3216Metric
CAL9, CAL10: CONN_01x01; FEMALE_SPADE_QC_(TE_63969-1)
CTRL_AMPS_5: CURRENT_AMP_(INA240A3); SOIC-8_3.9x4.9mm_P1.27mm
CTRL_CONN_5: POSITRONIC_CONN_(CBD13W6F); POSITRONIC_D-SUB_(CBD13W6F35S600X_AA)
CTRL_SHUNT_5: SHUNT_(WSL40261L000FEA)
D7, D12: D; D_SMA
PUMP_AMPS_5: CURRENT_AMP_(INA240A2); SOIC-8_3.9x4.9mm_P1.27mm
PUMP_CONN_5: SCREW_TB_(1906129); PHNX_TB_SCREW_4_POS_(1906129)
PUMP_FUSE_5: FUSE_HOLDER_(01220083Z)
PUMP_PWR_CONN_5: SCREW_TB_(1906129); PHNX_TB_SCREW_4_POS_(1906129)
PUMP_SHUNT_5: SHUNT_(WSL40261L000FEA)
PUMP_V_CONN_5: CONN_01X04; PHX_TB_HDR_4_POS_STR_(1755752)
PWR_RLY_5: CIT_AUTO_RELAY_(A21CSQ24VDC1.6); TE_AUTO_RELAY_SOCKET_(VCF4-1000)
Q20: MOSFET_N_(ZVN3320FTA); SOT-23
Q22: MOSFET_N_(DMN61D8LQ-13); SOT-23
R11: 2k; R_1206_3216Metric
R76, R83: 10k; R_1206_3216Metric
R79: 150; R_1206_3216Metric
R82: 1M; R_1206_3216Metric
R84: 100k; R_1206_3216Metric

Connections:
3.3VDC: C39.1, C40.1, CTRL_AMPS_5.6 (VS), PUMP_AMPS_5.3 (REF2), PUMP_AMPS_5.6 (VS), R11.2; also elsewhere on the board
24VDC: PWR_RLY_5.86 (C+); also elsewhere on the board
+S_CTRL_5: CTRL_CONN_5.1 (+SENSE), R84.1; also elsewhere on the board
+S_PUMP_5: D12.1 (K); also elsewhere on the board
-S_CTRL_5: CTRL_CONN_5.2 (-SENSE), R83.1; also elsewhere on the board
-S_PUMP_5: PUMP_V_CONN_5.2; also elsewhere on the board
AI4: R83.2, R84.2; also elsewhere on the board
AI20: C41.1, PUMP_AMPS_5.5 (OUT); also elsewhere on the board
AI26: C42.1, CTRL_AMPS_5.5 (OUT); also elsewhere on the board
CAN_HI: CTRL_CONN_5.6 (CAN_HI); also elsewhere on the board
CAN_LO: CTRL_CONN_5.7 (CAN_LO); also elsewhere on the board
DIO4: R76.2, R79.2; also elsewhere on the board
DIO10: Q22.1 (G); also elsewhere on the board
GND: C26.2, C39.2, C40.2, C41.2, C42.2, CTRL_AMPS_5.2 (GND), CTRL_AMPS_5.3 (REF2), CTRL_AMPS_5.7 (REF1), CTRL_CONN_5.0 (SHLD), CTRL_CONN_5.A2 (GND), D7.2 (A), PUMP_AMPS_5.2 (GND), PUMP_AMPS_5.7 (REF1), PUMP_CONN_5.4, PUMP_PWR_CONN_5.2, PUMP_PWR_CONN_5.3, Q20.2 (S), Q22.2 (S), R76.1; also elsewhere on the board
unnamed: CAL9.1, CTRL_SHUNT_5.4, PWR_RLY_5.87 (NO), R82.2
unnamed: C26.1, CAL10.1, D7.1 (K), PUMP_CONN_5.1, PUMP_SHUNT_5.1
unnamed: CTRL_AMPS_5.8 (IN+), CTRL_SHUNT_5.3
unnamed: CTRL_AMPS_5.1 (IN-), CTRL_SHUNT_5.2
unnamed: CTRL_CONN_5.A3 (P1), PUMP_SHUNT_5.4
unnamed: CTRL_CONN_5.A4 (P2), PUMP_CONN_5.2
unnamed: CTRL_CONN_5.A5 (P3), PUMP_CONN_5.3
unnamed: CTRL_CONN_5.3 (PWM_CMD), PUMP_V_CONN_5.4, Q20.3 (D), R82.1
unnamed: CTRL_CONN_5.A1 (V_BATT), CTRL_SHUNT_5.1
unnamed: D12.2 (A), PUMP_V_CONN_5.1
unnamed: PUMP_AMPS_5.8 (IN+), PUMP_SHUNT_5.3
unnamed: PUMP_AMPS_5.1 (IN-), PUMP_SHUNT_5.2
unnamed: PUMP_FUSE_5.6, PUMP_FUSE_5.7, PUMP_PWR_CONN_5.1, PWR_RLY_5.30 (POLE)
unnamed: PUMP_FUSE_5.4, PUMP_FUSE_5.5, PUMP_PWR_CONN_5.4
unnamed: PWR_RLY_5.85 (C-), Q22.3 (D)
unnamed: Q20.1 (G), R79.1
POS_5_DIAG: CTRL_CONN_5.4 (DIAG), PUMP_V_CONN_5.3, R11.1; also elsewhere on the board
POS_5_SPR_1: CTRL_CONN_5.A6 (SPARE_1); also elsewhere on the board
POS_5_SPR_2: CTRL_CONN_5.5 (SPARE_2); also elsewhere on the board

Notes on the sheet:
GND
PWM_CMD
-SENSE
V_BATT
GND
CAP-
CAP+
DIAG
+SENSE

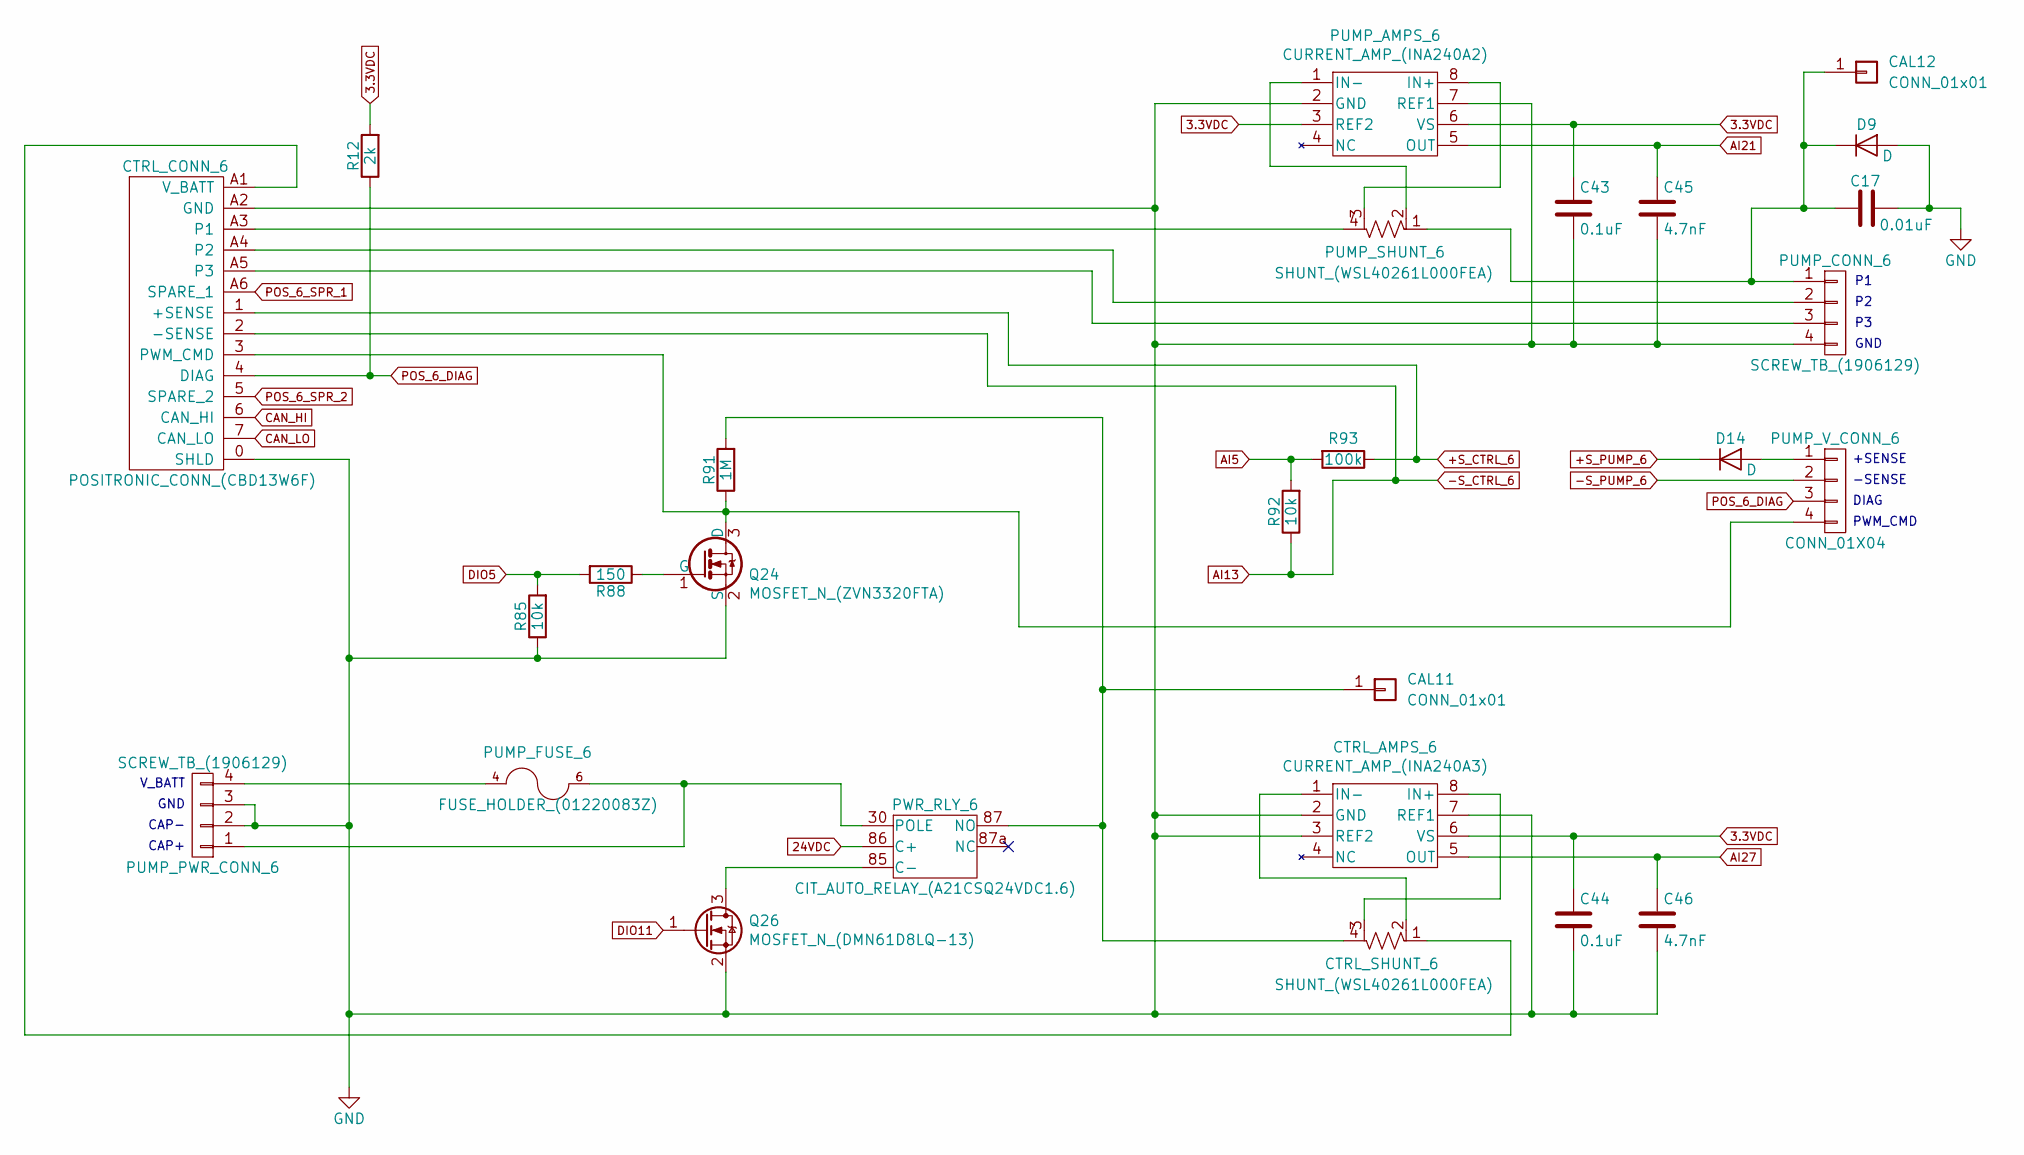
[picture p20: schematic POSITION_6.kicad_sch]

Parts:
C17: 0.01uF; C_1206_3216Metric
C43, C44: 0.1uF; C_1206_3216Metric
C45, C46: 4.7nF; C_1206_3216Metric
CAL11, CAL12: CONN_01x01; FEMALE_SPADE_QC_(TE_63969-1)
CTRL_AMPS_6: CURRENT_AMP_(INA240A3); SOIC-8_3.9x4.9mm_P1.27mm
CTRL_CONN_6: POSITRONIC_CONN_(CBD13W6F); POSITRONIC_D-SUB_(CBD13W6F35S600X_AA)
CTRL_SHUNT_6: SHUNT_(WSL40261L000FEA)
D9, D14: D; D_SMA
PUMP_AMPS_6: CURRENT_AMP_(INA240A2); SOIC-8_3.9x4.9mm_P1.27mm
PUMP_CONN_6: SCREW_TB_(1906129); PHNX_TB_SCREW_4_POS_(1906129)
PUMP_FUSE_6: FUSE_HOLDER_(01220083Z)
PUMP_PWR_CONN_6: SCREW_TB_(1906129); PHNX_TB_SCREW_4_POS_(1906129)
PUMP_SHUNT_6: SHUNT_(WSL40261L000FEA)
PUMP_V_CONN_6: CONN_01X04; PHX_TB_HDR_4_POS_STR_(1755752)
PWR_RLY_6: CIT_AUTO_RELAY_(A21CSQ24VDC1.6); TE_AUTO_RELAY_SOCKET_(VCF4-1000)
Q24: MOSFET_N_(ZVN3320FTA); SOT-23
Q26: MOSFET_N_(DMN61D8LQ-13); SOT-23
R12: 2k; R_1206_3216Metric
R85, R92: 10k; R_1206_3216Metric
R88: 150; R_1206_3216Metric
R91: 1M; R_1206_3216Metric
R93: 100k; R_1206_3216Metric

Connections:
3.3VDC: C43.1, C44.1, CTRL_AMPS_6.6 (VS), PUMP_AMPS_6.3 (REF2), PUMP_AMPS_6.6 (VS), R12.2; also elsewhere on the board
24VDC: PWR_RLY_6.86 (C+); also elsewhere on the board
+S_CTRL_6: CTRL_CONN_6.1 (+SENSE), R93.1; also elsewhere on the board
+S_PUMP_6: D14.1 (K); also elsewhere on the board
-S_CTRL_6: CTRL_CONN_6.2 (-SENSE), R92.1; also elsewhere on the board
-S_PUMP_6: PUMP_V_CONN_6.2; also elsewhere on the board
AI5: R92.2, R93.2; also elsewhere on the board
AI21: C45.1, PUMP_AMPS_6.5 (OUT); also elsewhere on the board
AI27: C46.1, CTRL_AMPS_6.5 (OUT); also elsewhere on the board
CAN_HI: CTRL_CONN_6.6 (CAN_HI); also elsewhere on the board
CAN_LO: CTRL_CONN_6.7 (CAN_LO); also elsewhere on the board
DIO5: R85.2, R88.2; also elsewhere on the board
DIO11: Q26.1 (G); also elsewhere on the board
GND: C17.2, C43.2, C44.2, C45.2, C46.2, CTRL_AMPS_6.2 (GND), CTRL_AMPS_6.3 (REF2), CTRL_AMPS_6.7 (REF1), CTRL_CONN_6.0 (SHLD), CTRL_CONN_6.A2 (GND), D9.2 (A), PUMP_AMPS_6.2 (GND), PUMP_AMPS_6.7 (REF1), PUMP_CONN_6.4, PUMP_PWR_CONN_6.2, PUMP_PWR_CONN_6.3, Q24.2 (S), Q26.2 (S), R85.1; also elsewhere on the board
unnamed: CAL11.1, CTRL_SHUNT_6.4, PWR_RLY_6.87 (NO), R91.2
unnamed: C17.1, CAL12.1, D9.1 (K), PUMP_CONN_6.1, PUMP_SHUNT_6.1
unnamed: CTRL_AMPS_6.8 (IN+), CTRL_SHUNT_6.3
unnamed: CTRL_AMPS_6.1 (IN-), CTRL_SHUNT_6.2
unnamed: CTRL_CONN_6.A3 (P1), PUMP_SHUNT_6.4
unnamed: CTRL_CONN_6.A4 (P2), PUMP_CONN_6.2
unnamed: CTRL_CONN_6.A5 (P3), PUMP_CONN_6.3
unnamed: CTRL_CONN_6.3 (PWM_CMD), PUMP_V_CONN_6.4, Q24.3 (D), R91.1
unnamed: CTRL_CONN_6.A1 (V_BATT), CTRL_SHUNT_6.1
unnamed: D14.2 (A), PUMP_V_CONN_6.1
unnamed: PUMP_AMPS_6.8 (IN+), PUMP_SHUNT_6.3
unnamed: PUMP_AMPS_6.1 (IN-), PUMP_SHUNT_6.2
unnamed: PUMP_FUSE_6.6, PUMP_FUSE_6.7, PUMP_PWR_CONN_6.1, PWR_RLY_6.30 (POLE)
unnamed: PUMP_FUSE_6.4, PUMP_FUSE_6.5, PUMP_PWR_CONN_6.4
unnamed: PWR_RLY_6.85 (C-), Q26.3 (D)
unnamed: Q24.1 (G), R88.1
POS_6_DIAG: CTRL_CONN_6.4 (DIAG), PUMP_V_CONN_6.3, R12.1; also elsewhere on the board
POS_6_SPR_1: CTRL_CONN_6.A6 (SPARE_1); also elsewhere on the board
POS_6_SPR_2: CTRL_CONN_6.5 (SPARE_2); also elsewhere on the board

Notes on the sheet:
DIAG
GND
CAP-
+SENSE
CAP+
-SENSE
PWM_CMD
GND
V_BATT

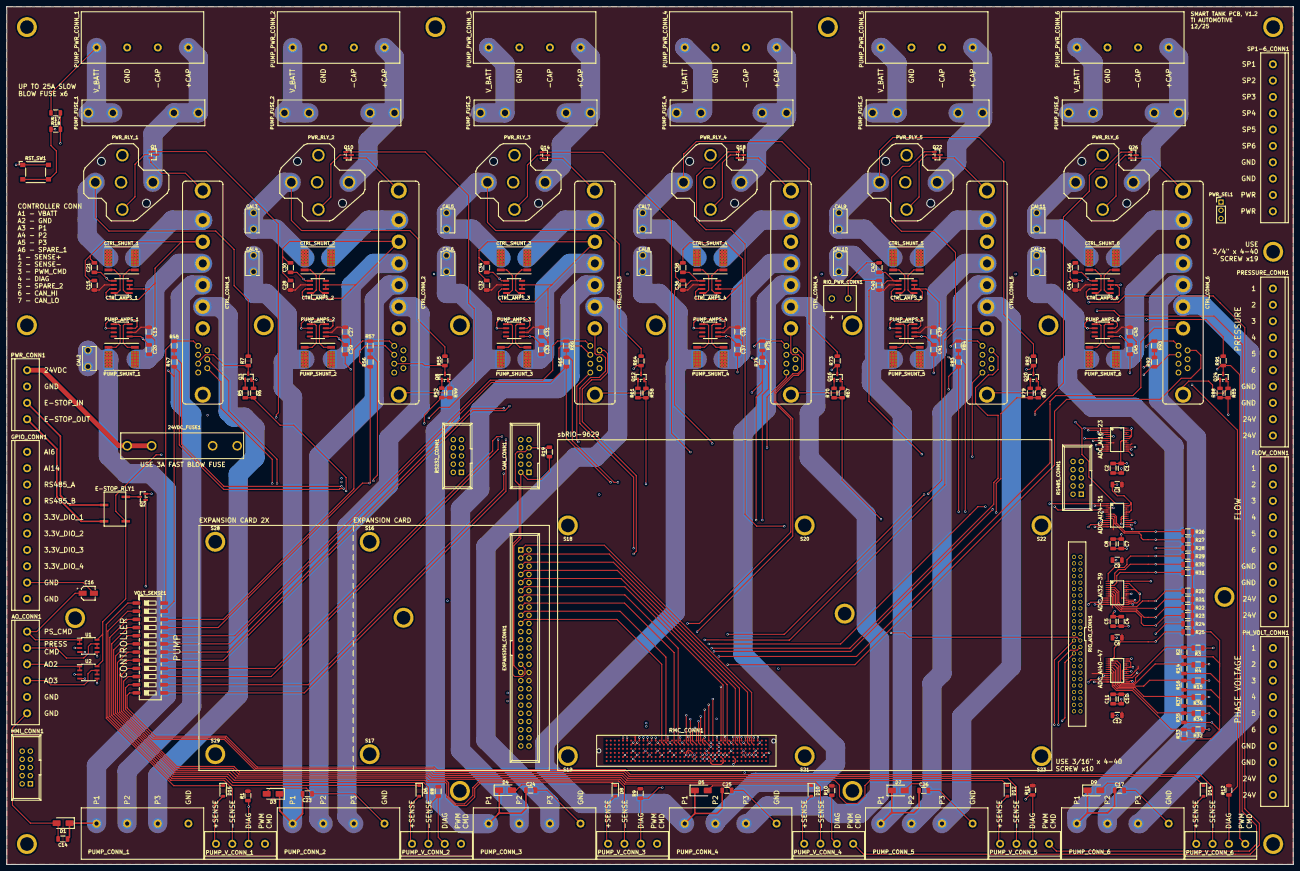
[picture p21: board Smart Tank Motherboard.kicad_pcb from above]

Board: 10 copper layers, 400.1 x 266.7 mm, 257 parts (0 on the bottom side), 267 nets.

Other parts of the board:
S1, S2, S3, S4, S5, S6, S7, S8, S9, S10, S11, S12, S13, S14, S15, S24, S25, S26, S27: PEM_STANDOFF_THRU_(SMTSOB-116-12ET)
S16, S17, S18, S19, S20, S21, S22, S23, S28, S29: MountingHole_3.2mm_M3; PEM_STANDOFF_4-40_(SMTSOB-440-12ET)
