titetil/smart-tank-pcb/Smart Tank Current Shunt/Smart Tank Current Shunt.kicad_pcb

## KiCad design Smart Tank Current Shunt/Smart Tank Current Shunt.kicad_pcb (2025-11-12)

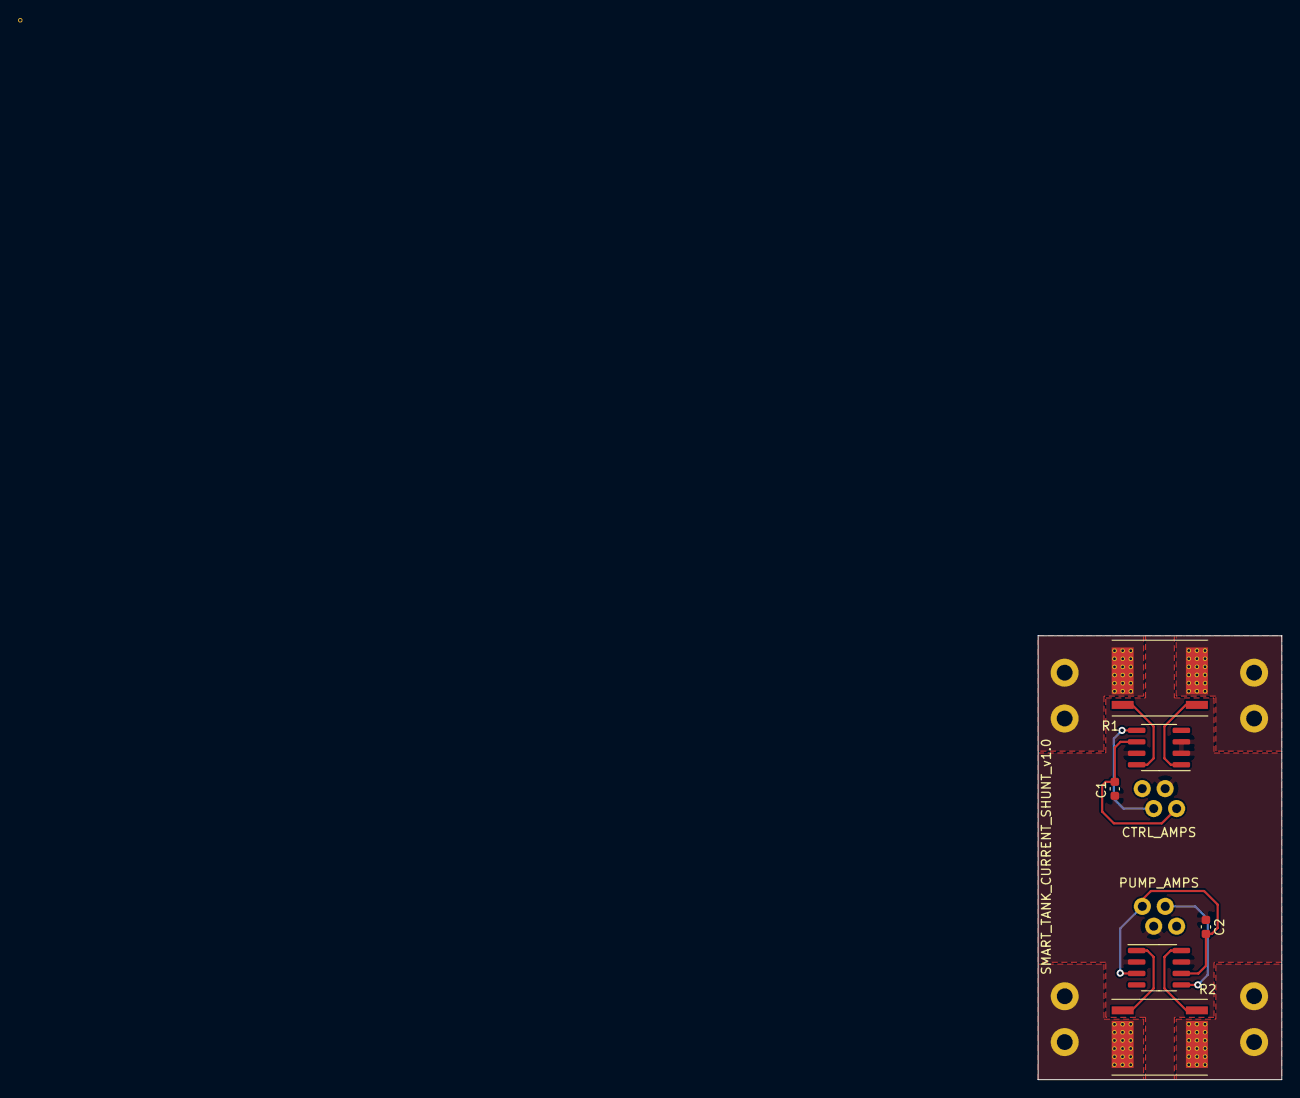
[picture p22: board Smart Tank Current Shunt.kicad_pcb from above]

Board: 6 copper layers, 27.0 x 49.2 mm, 7 parts (0 on the bottom side), 13 nets.

Parts:
C1, C2: 0.1uF; C_0603_1608Metric
CTRL_AMPS: CURRENT_AMP_(INA240A3); SOIC-8_3.9x4.9mm_P1.27mm
J1: CURRENT_SHUNT_INTERFACE; SMART_TANK_SHUNT_INTERFACE
PUMP_AMPS: CURRENT_AMP_(INA240A3); SOIC-8_3.9x4.9mm_P1.27mm
R1, R2: SHUNT_(WSL40261L000FEA)

Connections:
Earth: C1.2, C2.2, CTRL_AMPS.2, CTRL_AMPS.3, CTRL_AMPS.7, J1.5, J1.11, PUMP_AMPS.2, PUMP_AMPS.7
unnamed: C1.1, CTRL_AMPS.6, J1.6
unnamed: C2.1, J1.12, PUMP_AMPS.3, PUMP_AMPS.6
unnamed: CTRL_AMPS.1, R1.2
unnamed: CTRL_AMPS.5, J1.4
unnamed: CTRL_AMPS.8, R1.3
unnamed: J1.1, R1.4
unnamed: J1.2, R1.1
unnamed: J1.7, R2.4
unnamed: J1.8, R2.1
unnamed: J1.10, PUMP_AMPS.5
unnamed: PUMP_AMPS.1, R2.2
unnamed: PUMP_AMPS.8, R2.3
