titetil/smart-tank-pcb/Flow Meter Amp/Flow Meter Amp.kicad_pcb

## KiCad design Flow Meter Amp/Flow Meter Amp.kicad_pcb (2017-03-30)

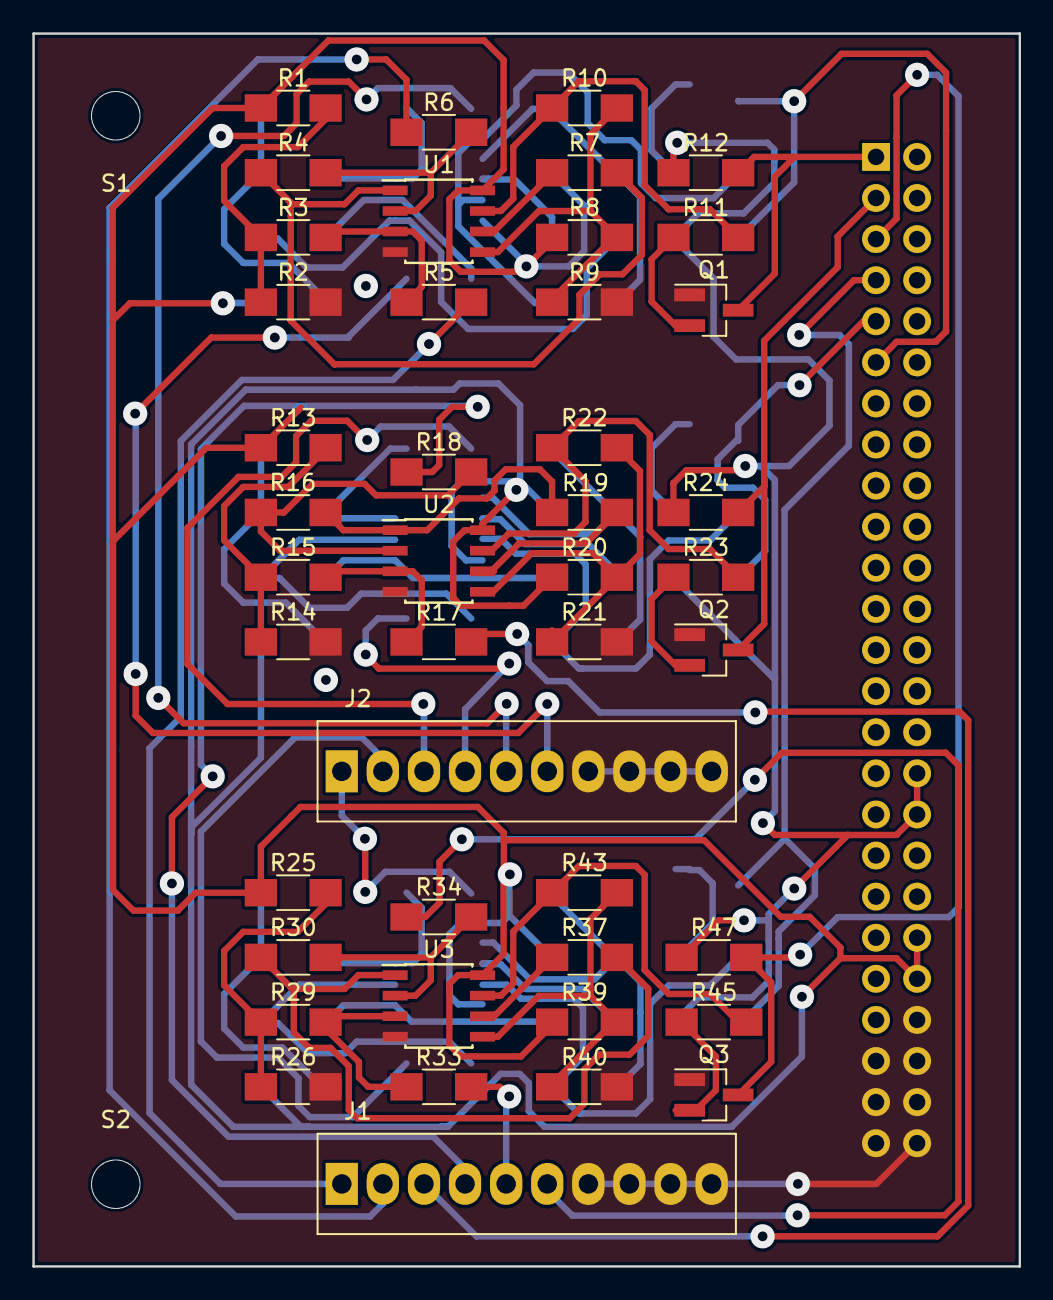
[picture p23: board Flow Meter Amp.kicad_pcb from above]

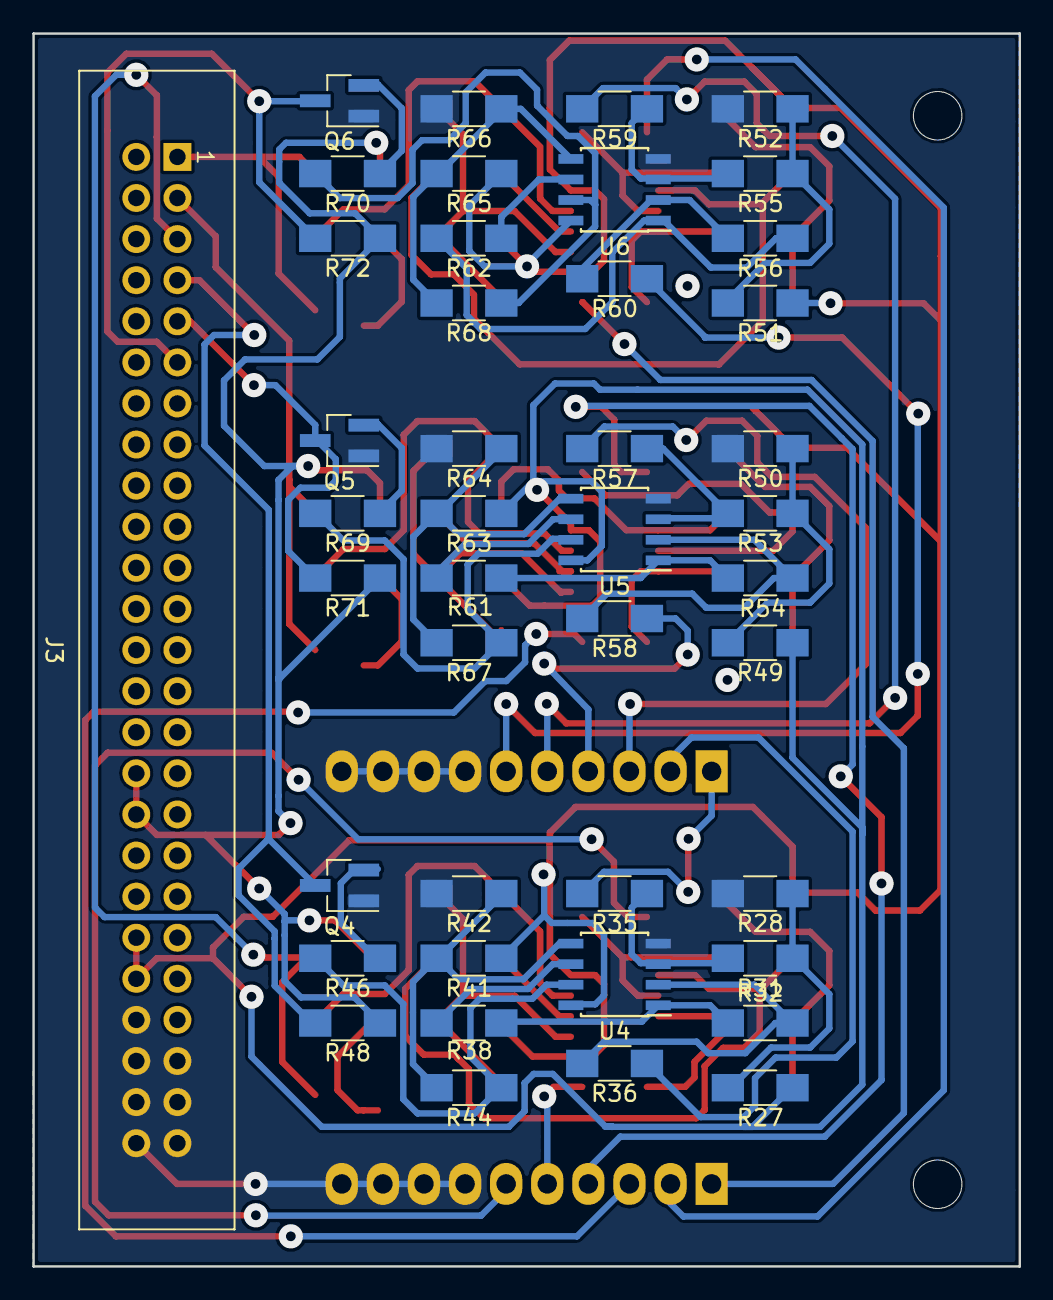
[picture p24: board Flow Meter Amp.kicad_pcb from below]

Board: 2 copper layers, 61.0 x 76.2 mm, 89 parts (43 on the bottom side), 69 nets.

Parts:
J1, J2: Screw_Terminal_1x10; PHNX_SCREW_CONN_10_POS_2.54_(1725737)
J3: CONN_02X25; 50_PIN_RECPT_(68683-325LF)
Q1, Q2, Q3, Q4, Q5, Q6: MMBT3904; SOT-23_Handsoldering
R1, R2, R13, R14, R25, R26, R27, R28, R49, R50, R51, R52: 2.2k; R_1206_HandSoldering
R3, R4, R15, R16, R29, R30, R31, R32, R53, R54, R55, R56: 499k; R_1206_HandSoldering
R5, R6, R17, R18, R33, R34, R35, R36, R57, R58, R59, R60: 3.32k; R_1206_HandSoldering
R7, R11, R19, R23, R37, R38, R45, R46, R61, R62, R69, R70: 10k; R_1206_HandSoldering
R8, R9, R20, R21, R39, R40, R41, R42, R63, R64, R65, R66: 100k; R_1206_HandSoldering
R10, R22, R43, R44, R67, R68: 1M; R_1206_HandSoldering
R12, R24, R47, R48, R71, R72: 1.2k; R_1206_HandSoldering
S1, S2: MountingHole_3mm
U1, U2, U3, U4, U5, U6: LM358; SOIC-8_3.9x4.9mm_Pitch1.27mm

Connections:
3.3VDC: J3.32, J3.34, R12.1, R24.1, R47.1, R48.1, R71.1, R72.1
24VDC: J3.40, J3.42, R1.1, R8.1, R13.1, R20.1, R25.1, R27.1, R39.1, R41.1, R49.1, R51.1, R63.1, R65.1, U1.8, U2.8, U3.8, U4.8, U5.8, U6.8
COM: J1.7, J1.8, J1.9, J1.10, J2.7, J2.8, J2.9, J2.10, J3.44, J3.45, J3.46, J3.47, J3.48, J3.49, J3.50, Q1.1, Q2.1, Q3.1, Q4.1, Q5.1, Q6.1, R2.2, R9.2, R14.2, R21.2, R26.2, R28.2, R40.2, R42.2, R50.2, R52.2, R64.2, R66.2, U1.4, U2.4, U3.4, U4.4, U5.4, U6.4
FLOW+_1: J1.1, R5.2
FLOW+_2: J1.3, R17.2
FLOW+_3: J1.5, R33.2
FLOW+_4: J2.1, R35.2
FLOW+_5: J2.3, R57.2
FLOW+_6: J2.5, R59.2
FLOW-_1: J1.2, R6.1
FLOW-_2: J1.4, R18.1
FLOW-_3: J1.6, R34.1
FLOW-_4: J2.2, R36.1
FLOW-_5: J2.4, R58.1
FLOW-_6: J2.6, R60.1
unnamed: Q1.2, R11.1
unnamed: Q2.2, R23.1
unnamed: Q3.2, R45.1
unnamed: Q4.2, R46.1
unnamed: Q5.2, R69.1
unnamed: Q6.2, R70.1
unnamed: R1.2, R2.1, R3.1
unnamed: R3.2, R5.1, U1.3
unnamed: R4.1, R7.2, U1.1
unnamed: R4.2, R6.2, U1.2
unnamed: R7.1, U1.6
unnamed: R10.1, R11.2, U1.7
unnamed: R8.2, R9.1, R10.2, U1.5
unnamed: R13.2, R14.1, R15.1
unnamed: R15.2, R17.1, U2.3
unnamed: R16.1, R19.2, U2.1
unnamed: R16.2, R18.2, U2.2
unnamed: R19.1, U2.6
unnamed: R20.2, R21.1, R22.2, U2.5
unnamed: R22.1, R23.2, U2.7
unnamed: R25.2, R26.1, R29.1
unnamed: R27.2, R28.1, R31.1
unnamed: R29.2, R33.1, U3.3
unnamed: R30.1, R37.2, U3.1
unnamed: R30.2, R34.2, U3.2
unnamed: R31.2, R35.1, U4.3
unnamed: R32.1, R38.2, U4.1
unnamed: R32.2, R36.2, U4.2
unnamed: R37.1, U3.6
unnamed: R38.1, U4.6
unnamed: R39.2, R40.1, R43.2, U3.5
unnamed: R41.2, R42.1, R44.2, U4.5
unnamed: R43.1, R45.2, U3.7
unnamed: R44.1, R46.2, U4.7
unnamed: R49.2, R50.1, R53.1
unnamed: R51.2, R52.1, R55.1
unnamed: R53.2, R57.1, U5.3
unnamed: R54.1, R61.2, U5.1
unnamed: R54.2, R58.2, U5.2
unnamed: R55.2, R59.1, U6.3
unnamed: R56.1, R62.2, U6.1
unnamed: R56.2, R60.2, U6.2
unnamed: R61.1, U5.6
unnamed: R62.1, U6.6
unnamed: R63.2, R64.1, R67.2, U5.5
unnamed: R65.2, R66.1, R68.2, U6.5
unnamed: R67.1, R69.2, U5.7
unnamed: R68.1, R70.2, U6.7
PULSE_OUT_1: J3.1, Q1.3, R12.2
PULSE_OUT_2: J3.3, Q2.3, R24.2
PULSE_OUT_3: J3.5, Q3.3, R47.2
PULSE_OUT_4: J3.7, Q4.3, R48.2
PULSE_OUT_5: J3.9, Q5.3, R71.2
PULSE_OUT_6: J3.11, Q6.3, R72.2
