titetil/smart-tank-pcb/(commit log)

2017-03-30 -finished Flow Meter Amp PCB design. ready to route.
    [Flow 3 and 4.sch, Flow 5 and 6.sch, Flow Meter Amp.kicad_pcb, Flow Meter Amp.sch, Smart Tank PCB Backplate.dwg, Smart Tank PCB Backplate.dxf]
2017-03-31 created gerbers and lmd file.
    [Flow Meter Amp-B.Cu.gbr, Flow Meter Amp-Edge.Cuts.gbr, Flow Meter Amp-F.Cu.gbr, Flow Meter Amp.drl]
2017-07-27 - Refer to Google Drive BOM for list of changes for v1.1 - Create drawing for Hella BLDC controller plate.
    [ANALOG_EXPANSION.sch, Bill of Materials.xlsx, POSITION_1.sch, POSITION_2.sch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]
2017-07-27 - Added board router files back in. They were deleted by accident.
    [Flow Meter Amp-B.Cu.gbr, Flow Meter Amp-Edge.Cuts.gbr, Flow Meter Amp-F.Cu.gbr, Flow Meter Amp.drl]
2020-06-10 - Created Modbus Adapter.
    [ANALOG_EXPANSION-2019-04-25-12-22-53.sch, ANALOG_EXPANSION-2019-05-06-07-12-51.sch, ANALOG_EXPANSION-2019-05-06-07-14-42.sch, ANALOG_EXPANSION.sch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]
2021-07-20 Created Smart Tank Current Shunt PCB, v1.0
    [Smart Tank Current Shunt-B_Cu.gbr, Smart Tank Current Shunt-B_Mask.gbr, Smart Tank Current Shunt-B_Paste.gbr, Smart Tank Current Shunt-B_SilkS.gbr, Smart Tank Current Shunt-Edge_Cuts.gbr, Smart Tank Current Shunt-F_Cu.gbr, Smart Tank Current Shunt-F_Mask.gbr, Smart Tank Current Shunt-F_Paste.gbr]
2025-11-12 Committing what appears to be a bunch of backup files. Haven't touched this project in a while, so I'm going for it.
    [Bill of Materials.xlsx, Flow 3 and 4-2023-11-03-08-46-06.sch, Flow 3 and 4-2024-02-13-13-29-30.sch, Flow 3 and 4-2024-02-13-13-31-19.sch, Flow 3 and 4-2024-06-25-15-02-38.sch, Flow 5 and 6-2023-11-03-08-46-06.sch, Flow 5 and 6-2024-02-13-13-29-30.sch, Flow 5 and 6-2024-02-13-13-31-19.sch]
2025-11-14 Finished schematic for next version. Need to assign footprints next.
    [ANALOG_EXPANSION.kicad_sch, Flow 3 and 4-2025-11-14-07-35-38.sch, Flow 3 and 4-2025-11-14-07-53-23.sch, Flow 5 and 6-2025-11-14-07-35-38.sch, Flow 5 and 6-2025-11-14-07-53-23.sch, Flow Meter Amp-2025-11-14-07-35-38.sch, Flow Meter Amp-2025-11-14-07-36-23.sch, Flow Meter Amp-2025-11-14-07-40-01.sch]
2025-11-17 Schematic ready. Going to clean up directory now.
    [ANALOG_EXPANSION.kicad_sch, EEEHD1C100AR.step, FEMALE_SPADE_QC_(TE_63969-1).step, POSITION_1.kicad_sch, POSITION_2.kicad_sch, POSITION_3.kicad_sch, POSITION_4.kicad_sch, POSITION_5.kicad_sch]
2025-11-17 Started cleaning out old parts from PCB.
    [ANALOG_EXPANSION.sch, Bill of Materials.xlsx, POSITION_1.kicad_sch, POSITION_1.sch, POSITION_2.kicad_sch, POSITION_2.sch, POSITION_3.kicad_sch, POSITION_3.sch]
2025-11-18 Continued cleanup and reconnects.
    [POSITION_1.kicad_sch, RIO_CONNECTIONS.kicad_sch, Smart Tank Motherboard.kicad_pcb]
2025-11-19 Almost done with re-routing.
    [POSITION_1.kicad_sch, POSITION_2.kicad_sch, POSITION_3.kicad_sch, POSITION_4.kicad_sch, POSITION_5.kicad_sch, POSITION_6.kicad_sch, Smart Tank Motherboard.kicad_pcb]
2025-12-01 Almost done with PCB. Tying up a few loose ends.
    [Smart Tank Motherboard.kicad_pcb, Smart Tank Motherboard.kicad_sch]
2025-12-03 Design files were sent out for quote.
    [Smart Tank Motherboard-B.Adhes.gbr, Smart Tank Motherboard-B.Cu_(High_Amps).gbr, Smart Tank Motherboard-B.Mask.gbr, Smart Tank Motherboard-B.Paste.gbr, Smart Tank Motherboard-B.SilkS.gbr, Smart Tank Motherboard-B_Adhesive.gbr, Smart Tank Motherboard-B_Cu_(High_Amps).gbr, Smart Tank Motherboard-B_Mask.gbr]
2026-02-18 Capacitor part issues...
    Made these changes...
    Concerning C13, C15, C27, C28, C31, C32, C35, C36, C39, C40, C43, C44
    The schematic is wrong, and the BOM is correct. These should all be 0.1uF
    Concerning C20, C21, C29, C30, C33, C34, C37, C38, C41, C42, C45, C46
    The BOM is wrong, and the schematic is correct. These should all be 4.7nF
    [POSITION_1.kicad_sch, POSITION_2.kicad_sch, POSITION_3.kicad_sch, POSITION_4.kicad_sch, POSITION_5.kicad_sch, POSITION_6.kicad_sch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]
